Omrover/MoMa-robot/README.md

# MoMa-robot
Documentación del desarrollo del robot MoMa (requerimientos, arquitectura, BOM, diseños, códigos, control de stock).
