Omrover/MoMa-robot/docs/Documentación/Flujo de Ingeniería.pdf

### Diagrama de flujo propuesto

Inicio

Liberación de diseño de ingeniería Planos, BOM, diagramas eléctricos y especificaciones aprobadas

Validación de
documentación técnica

¿Documentación
completa y
aprobada?

Corrección /
actualización de
ingeniería

Verificación de
disponibilidad
de materiales

¿Todos los
materiales están
disponibles?

Solicitud a
Compras

Seguimiento
a proveedor

Recepción e
inspección

Generar Orden de Fabricación (OF)

Preparación de materiales / Kitting

Fabricación de piezas necesarias

Ensamble mecánico

Inspección mecánica
Torque, dimensiones, fijaciones y montaje

¿Ensamble
mecánico
conforme?

Retrabajo

Ensamble
eléctrico y
electrónico

Pruebas eléctricas
Continuidad, conexiones,
alimentación y seguridad

¿Sistema
eléctrico
conforme?

Corrección

Carga e
implementación
de
software/control

Integración de
subsistemas
Mecánica + electrónica +
software

Pruebas
funcionales
del sistema

¿Cumple
requerimientos
técnicos y de
seguridad?

Registrar no
conformidad

Análisis de
causa

Corrección/retrabajo

Control de
Calidad final
(QA)

Liberación
del equipo

Cierre de
Orden de
Fabricación

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
Añadir título

Archivos relevantes | Notas del chat

diagrama-flujo-agv.txt

### Diagrama de Flujo de Ingeniería

### Last Updated: 20 de ago. de 2026 Scope: Proceso completo de fabricación y liberación de un AMR, desde la liberación y validación del diseño de ingeniería hasta el cierre de la Orden de

Fabricación y la liberación final del equipo.

Referencias del
diagrama
Terminador
Proceso
Decisión

Proceso de Fabricación y Liberación de AGV

Información del diagrama
Este diagrama representa el flujo completo para fabricar, ensamblar, probar y liberar un vehículo guiado automático (AMR) inegrado con un brazo robótico. El proceso inicia con la liberación de la ingeniería, valida la documentación y los materiales, continúa con la fabricación e integración mecánica, eléctrica y de software, y finaliza con las pruebas, el control de calidad y el cierre de la orden de fabricación. Las rutas de corrección, retrabajo y abastecimiento aseguran que el equipo cumpla los requisitos técnicos y de seguridad.
