Omrover/MoMa-robot/docs/Documentación/Flujo_de_trabajo_Flexsim.jpeg

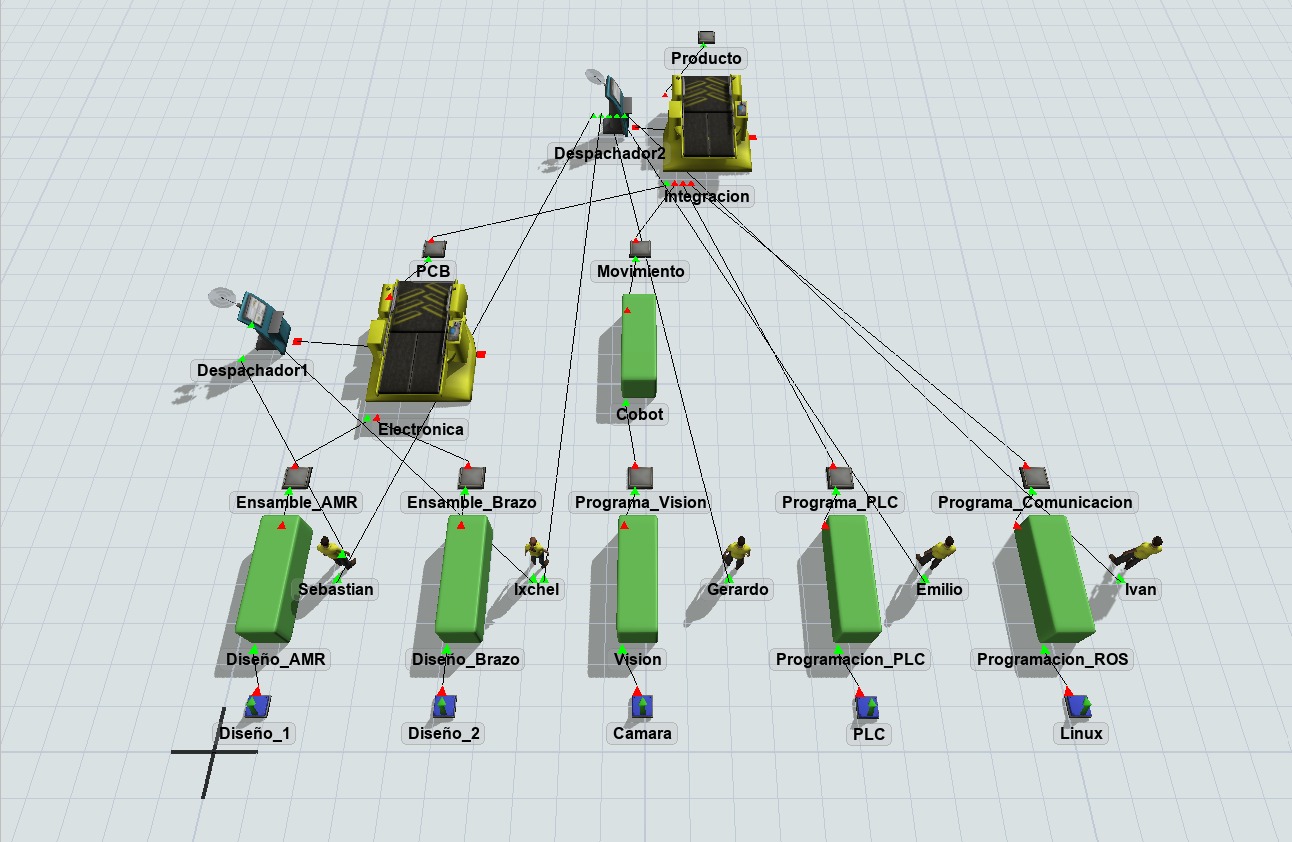
docs/Documentación/Flujo_de_trabajo_Flexsim.jpeg
