Omrover/MoMa-robot/docs/Documentación/Tablero_Kanban.png

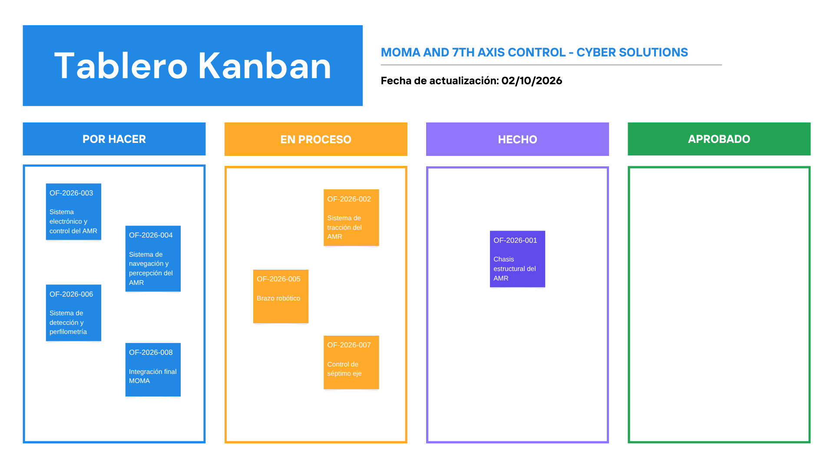
docs/Documentación/Tablero_Kanban.png
