Omrover/MoMa-robot/docs/Control Stock/OF_HojasViajeras_Materiales_ERP_CyberSolutions.xlsx

Sheet: Órdenes de fabricación
Órdenes de fabricación
ID | Fecha de emisión | Fecha liímite | Producto | Cantidad a producir | Prioridad
OF-2026-001 | 2026-09-03 | 2026-09-20 | Chasis estructural del AMR | 1 | ALTA
OF-2026-002 | 2026-09-04 | 2026-09-25 | Sistema de tracción del AMR | 1 | ALTA
OF-2026-003 | 2026-09-05 | 2026-09-27 | Sistema electrónico y control del AMR | 1 | ALTA
OF-2026-004 | 2026-09-06 | 2026-09-27 | Sistema de navegación y percepción del AMR | 1 | ALTA
OF-2026-005 | 2026-09-07 | 2026-09-28 | Brazo robótico | 1 | MEDIA
OF-2026-006 | 2026-09-08 | 2026-10-05 | Sistema de detección y perfilometría | 1 | BAJA
OF-2026-007 | 2026-09-09 | 2026-10-20 | Séptimo eje | 1 | BAJA
OF-2026-008 | 2026-09-10 | 2026-11-13 | Integración final MOMA | 1 | BAJA

Sheet: Hoja Viajera
 | HOJA VIAJERA DE PRODUCCIÓN
 | INFORMACIÓN DE LA ORDEN DE TRABAJO
 | N° Orden Trabajo: | OT-10025 |  |  |  | Fecha Inicio: | 2026-10-05
 | Producto/Parte: | AMR |  |  |  | Fecha Entrega: | 2026-12-04
 | Cantidad Requerida: | 1 |  |  |  | Cliente: | Socio Formador
ID | Op. | Centro de Trabajo | Descripción del Proceso | Operador | Inicio | Fin | Cant. Buena | Scrap | Firma Calidad
OF-2026-001 | 10 | Almacén | Surtido de material
 | 20 | Cortadora | Corte de PTR
 | 30 | Taladro | Perforaciones
 | 40 | Soldadura | Ensamble estructural
 | 50 | Rectificado | Acabado
 | 60 | Calidad | Inspección dimensional
OF-2026-002 | 10 | Almacén | Motores Chihai + drivers + batería + cable
 | 20 | Ensamble mecánico | Motores Chihai + ruedas
 | 30 | Ensamble mecánico | Ejes + elementos de transmisión
 | 40 | Ensamble eléctrico | Drivers Roboclaw
 | 50 | Cableado | Cable calibre 12
 | 60 | Pruebas eléctricas | Sistema de tracción
 | 70 | Pruebas funcionales | AMR
OF-2026-003 | 10 | Almacén | PCB + componentes electrónicos
 | 20 | Electrónica | PCB + resistencias
 | 30 | Electrónica | Optoacopladores + diodos + capacitores
 | 40 | Soldadura electrónica | PCB ensamblada
 | 50 | Programación | NXP / microcontrolador
 | 60 | Pruebas electrónicas | PCB
 | 70 | Integración eléctrica | PCB + sensores + cableado
 | 80 | Inspección | Sistema electrónico
OF-2026-004 | 10 | Almacén | Intel NUC + LiDAR + cámara
 | 20 | Ensamble | Soportes + Intel NUC
 | 30 | Ensamble | RPLiDAR
 | 40 | Ensamble | Logitech C920
 | 50 | Cableado | Cable UTP
 | 60 | Programación | NUC + software de navegación
 | 70 | Calibración | LiDAR + cámara
 | 80 | Pruebas | Sistema de navegación
OF-2026-005 | 10 | Almacén | Aluminio + acero + PLA-CF
 | 20 | Corte | Solera de aluminio
 | 30 | Maquinado | Componentes estructurales
 | 40 | Impresión 3D | PLA-CF
 | 50 | Ensamble mecánico | Estructura + piezas impresas
 | 60 | Ensamble | Rodamientos + tornillería
 | 70 | Ensamble eléctrico | Motores brushless
 | 80 | Ensamble eléctrico | Servomotor
 | 90 | Cableado | Cableado del brazo
 | 100 | Programación | Control del brazo
 | 110 | Pruebas | Movimiento de articulaciones
 | 120 | Inspección | Brazo robótico
OF-2026-006 | 10 | Almacén | Perfilómetro
 | 20 | Ensamble | Perfilómetro + soporte
 | 30 | Integración | Perfilómetro + computadora
 | 40 | Programación | Software de adquisición
 | 50 | Calibración | Perfilómetro
 | 60 | Procesamiento | Datos de perfil
 | 70 | Visión | Obtención de pose
 | 80 | Validación | Sistema de detección
OF-2026-007 | 10 | Almacén | Componentes del séptimo eje
 | 20 | Corte | Perfil/estructura
 | 30 | Maquinado | Soportes
 | 40 | Ensamble mecánico | Estructura + guía
 | 50 | Ensamble | Actuador + motor
 | 60 | Cableado | Motor + sensores
 | 70 | Programación | Control del eje
 | 80 | Calibración | Séptimo eje
 | 90 | Pruebas | Movimiento lineal
 | 100 | Inspección | Séptimo eje
OF-2026-008 | 10 | Almacén | AMR-001
 | 20 | Almacén | BRAZO-001
 | 30 | Ensamble | AMR + brazo
 | 40 | Integración | Sistema de perfilometría
 | 50 | Integración | Séptimo eje
 | 60 | Integración eléctrica | Cableado general
 | 70 | Integración de comunicaciones | AMR + visión + brazo + CNC
 | 80 | Calibración | Cámara
 | 90 | Calibración | Perfilómetro
 | 100 | Calibración | Brazo
 | 110 | Calibración | Séptimo eje
 | 120 | Integración CNC | MOMA + CNC
 | 130 | Pruebas | Detección de pieza
 | 140 | Pruebas | Cálculo de pose
 | 150 | Pruebas | Pick & place
 | 160 | Pruebas | Carga de pieza en CNC
 | 170 | Prueba final | Ciclo automático completo
 | 180 | Calidad | Inspección final

Sheet: consolidado_materiales
CONSOLIDADO MASTER DE MATERIALES Y COMPONENTES
ID | Proyecto | Componente / Descripción | Proveedor | Modelo / Código | Cantidad | Unidad | Subtotal Lineal ($) | Tiempo Entrega | País Origen | Contacto | Ficha Técnica | Fecha Cotización | Riesgo Suministro | Estatus OC
AMR | AMR | PTR 1/2''x1/2'' calibre 16 | MARSA ACEROS | Acero al carbón | 6 | metros | $600.00 | Inmediato | México | 3318941761 | https://neufert-cdn.archdaily.net/uploads/product_file/file/2979/Informaci_n_t_cnica_Tuber_a_y_Perfiles.pdf | 8/20/2026 | Bajo | Generado
AMR2 | AMR | Filamento para impresión | Amazon | Filamento Creality PLA-CF | 1 | kg | $472.00 | 2-5 días | México | https://www.amazon.com.mx/Creality-Filamento-Velocidad-Precisi%C3%B3n-Dimensional/dp/B0CW2HNX9Z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 | https://store.creality.com/es/products/hyper-pla-cf | 8/20/2026 | Medio | Generado
AMR3 | AMR | Motor | Aliexpress | Chihai | 4 | Pza | $2575.60 | 1-4 semanas | China | 86-14775544575 | https://es.aliexpress.com/item/32822227433.html?src=google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 | 8/20/2026 | Medio | Generado
AMR4 | AMR | Microcontrolador | NXP | NXP S32K344 | 1 | Pza | $1017.45 | 1 - 2 días | México | https://support.nxp.com/s/?language=en_US | S32K3xx Data Sheet | 8/20/2026 | Medio | Generado
AMR5 | AMR | PCB | JLCPCB | NA | 2 | Pza | $200.00 | 1 semana | China | hk@jlcpcb.com | ¿Qué es una PCB o Placa de Circuito Impreso? | Altium | 8/20/2026 | Medio | Generado
AMR6 | AMR | Computadora | Intel | Nuc 13 Pro | 1 | Pza | $8060.00 | 3 días | México | 33 2265 3660 | https://gzhls.at/blob/ldb/3/0/e/6/3258a588b77a736bbb371eaa7d358c35de33.pdf | 8/20/2026 | Bajo | Generado
AMR7 | AMR | Lidar | ZICZNT | Rplidar A1M8 | 1 | Pza | $1525.83 | 2 semanas | China | support@siminics.com | https://www.slamtec.com/en/lidar/a1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 | 8/20/2026 | Medio | Generado
AMR8 | AMR | Web cam | Amazon | Logitech C920 | 1 | Pza | $1222.00 | 2-5 días | México | https://www.amazon.com.mx/Logitech-Webcam-Resoluci%C3%B3n-FullHD-1080p/dp/B006JH8T3S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 | https://www.logitech.com/es-mx/shop/p/c920-pro-hd-webcam | 8/20/2026 | Bajo | Generado
AMR9 | AMR | Drivers | SanDoRobotics | Roboclaw 2x45 | 2 | Pza | $12960.00 | 3-7 días | México | 5557683208 | https://core-electronics.com.au/attachments/localcontent/roboclaw_datasheet_ST_2x45A_43321507500.pdf | 8/20/2026 | Bajo | Generado
AMR10 | AMR | Resistencia | Mexbit | 10 k omh | 10 | Pza | $20.00 | inmediato | México | 33 34495988 | RESISTOR Datasheet(PDF) - DMR16 - Dubilier | 8/20/2026 | Bajo | Generado
AMR11 | AMR | Optoacoplador | Mexbit | 4n25 | 10 | Pza | $80.00 | inmediato | México | 33 34495988 | 4n25.pdf | 8/20/2026 | Bajo | Generado
AMR12 | AMR | Diodo | Mexbit | 1n4007 | 10 | Pza | $30.00 | inmediato | México | 33 34495988 | 1N4007 Datasheet(PDF) - Diodes Incorporated | 8/20/2026 | Bajo | Generado
AMR13 | AMR | Capacitor | Mexbit | 10 mF | 10 | Pza | $40.00 | inmediato | México | 33 34495988 | 10 mF Aluminum Electrolytic Capacitors | Capacitors | DigiKey | 8/20/2026 | Bajo | Generado
AMR14 | AMR | Cables UTP | Mexbit | UTP | 5 | m | $30.00 | inmediato | México | 33 34495988 | https://assets.tripplite.com/product-pdfs/es/n002006bl.pdf | 8/20/2026 | Bajo | Generado
AMR142 | AMR | Cable Calibre 12 | Mexbit | Calibre 12 | 3 | m | $30.00 | Inmediato | México | 33 34495988 | Ficha Técnica | 8/20/2026 | Bajo | Generado
AMR15 | AMR | Bateria | Aliexpress | 24V LiPo | 1 | Pza | $1400.00 | 2-4 semanas | China | 1103456202 | 24V 30Ah 6s3p 18650 batería de litio 24V 30000mAh batería de iones de litio + cargador - AliExpress 44 | 8/20/2026 | Medio | Generado
AMR16 | AMR | Sensor Infrarrojo difuso | Amazon | E18-B03N1 | 5 | Pza | $825.00 | 2 semanas | China | https://www.amazon.com.mx/Sensor-fotoel%C3%A9ctrico-interruptor-E18-B03P1-Interruptor/dp/B07SW6JF6S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 | E18-B03N1 Infrared Proximity Photoelectric Switch | RAM Electronics | 8/20/2026 | Medio | Generado
Brazo robotico | Brazo Robótico | Motor brushless 8NM GIM8108-48 | Elf te Motor-Steadywin Official Store | GIM8108-8 | 3 | Pza | $1706.70 | 1 - 4 semanas | China | +86 13077918423 | https://ae-pic-a1.aliexpress-media.com/kf/Sb67d8ccea6ae4649b51a2712f7c8611eg.pdf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 | 8/20/2026 | Medio | Generado
Brazo robotico 2 | Brazo Robótico | Motor brushless 3NM | Elf te Motor-Steadywin Official Store | GB3506 | 3 | Pza | $1450.20 | 2 - 4 semanas | China | +86 13077918423 | https://steadywin-motor.com/cdn/shop/files/3506_2000x.jpg?v=1750326533 | 8/20/2026 | Medio | Generado
Brazo robotico 3 | Brazo Robótico | Filamento para impresión | Amazon | Filamento Creality PLA-CF | 3 | kg | $1260.00 | 2-5 días | México | https://www.amazon.com.mx/Creality-Filamento-Velocidad-Precisi%C3%B3n-Dimensional/dp/B0CW2HNX9Z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 | https://store.creality.com/es/products/hyper-pla-cf | 8/20/2026 | Medio | Generado
Brazo robotico 4 | Brazo Robótico | Servomotor | Steren | MOT-135 | 1 | Pza | $199.00 | inmediato | México | 55 1516 6000 | https://www.steren.com.mx/servomotor-con-torque-de-10-kgf-cm.html | 8/20/2026 | Bajo | Generado
Brazo robotico 5 | Brazo Robótico | Cables UTP | Mexbit | UTP | 5 | m | $30.00 | inmediato | México | 33 34495988 | https://assets.tripplite.com/product-pdfs/es/n002006bl.pdf | 8/20/2026 | Bajo | Generado
Brazo robotico 6 | Brazo Robótico | Cable Calibre 12 | Mexbit | Calibre 12 | 3 | m | $30.00 | Inmediato | México | 34 34495988 | Ficha Técnica | 8/20/2026 | Bajo | Generado
Brazo robotico 7 | Brazo Robótico | Lamina de acero | MARSA ACEROS | Calibre 16 | 1 | kg | $28.00 | Inmediato | México | 3318941761 | https://acerosmarsal.com.mx/lamina-rc/ | 8/20/2026 | Bajo | Generado
Brazo robotico 8 | Brazo Robótico | Solera de alumino | Mar China | Aluminio 6061 | 4 | ''x14''x1/4'' | $2720.88 | Inmediato | México | 33 3620 8756 | SOLERA 1/4 x 6 plg ALUMINIO 17592 | METALES MarChina - ¡Todo en Aluminio, Metales NO Ferrosos y Plásticos! | 8/20/2026 | Bajo | Generado
Brazo robotico 9 | Brazo Robótico | tornillos | Lizar | Allen | 40 | Pza | $200.00 | Inmediato | México | 33 3124 5228 | https://es.scribd.com/document/1065520561/Ficha-Tecnica-Torn-Allen-Cilindrico-Metrico | 8/20/2026 | Bajo | Generado
Brazo robotico 10 | Brazo Robótico | Rodamiento de rodillos cruzados | Amazon | SHF-14 | 1 | Pza | $2566.00 | 3-10 días | Estados Unidos | https://www.amazon.com.mx/Rodamiento-rodillos-cruzados-SHF-14-SHF-17/dp/B0HCNCN74D | https://lkpbearing.com/shf14-shg14-harmonic-reducer-bearings/ | 8/20/2026 | Medio | Generado
 |  | TOTAL CONSOLIDADO |  |  |  |  | $41278.66

Sheet: Maestro Materiales ERP
MÓDULO ERP: CONTROL Y GENERACIÓN DE CÓDIGOS DE MATERIALES
CÓDIGO ERP (Autogenerado) | Categoría | Tipo de Material | Número de Parte | Descripción Completa | Fabricante / Marca | UOM (Unidad) | Costo Unitario | Stock Actual
MEC-MOT-CHI-000 | MECÁNICA | Motor | CHI-000 | Chihai motor Gear Motor CHP-42GP-775-ABHL 24V 165rmp-i49 | Chihai | PZA | $786.00 | 4
MEC-MOT-BRUSH-000 | MECÁNICA | Motor | BRUSH-000 | Motor brushless 8NM GIM8108-48 |  | PZA | $586.00 | 3
COM-MICRO-NXP-312 | COMPUTACIÓN | Microcontrolador | NXP-312 | Microcontrolador NXP S32K312MINI-EVB | NXP | PZA | $600.00 | 5
MEC-FIL-PLA-000 | MECÁNICA | Filamento para impresión 3D | PLA-000 | Filamento PLA Standard Hatchbox | Hatchbox | PZA | $472.00 | 1
MEC-FIL-TPU-000 | MECÁNICA | Filamento para impresión 3D | TPU-000 | Filamento TPU CR Series Creality | Creality | PZA | $500.00 | 1
INT-DVR-RC-000 | INSTRUMENTACION | Driver | RC-000 | Driver de motor Roboclaw 2x45ST | Roboclaw | PZA | $6480.00 | 2
MEC-ROD-SH14-000 | MECÁNICA | Rodamiento | SHF14-000 | Rodamiento de rodillos cruzados SHF-14 | EFANT | PZA | $689.90 | 1
ELE-BAT-SOCO-000 | ELECTRÓNICA | Bateria | SOCO-000 | Batería de 24V 6000mAh | SOCOKIN | PZA | $4027.00 | 1
ELE-BAT-TEST-000 | ELECTRÓNICA | LiPo Tester | TEST-000 | Probador de voltaje de batería LiPo | Vbestlife | PZA | $65.00 | 1
ELE-ENC-ENCO-000 | ELECTRÓNICA | Encoder | ENCO-000 | Encoder de doble cuadratura | OMRON | PZA | $1750.00 | 4
ELE-LiD-LiD-000 | ELECTRÓNICA | LiDAR | LiD-000 | LiDAR | RPLiDAR | PZA | $1500.00 | 1
MEC-TER-HEAT-000 | MECÁNICA | Tubo termorretráctil | HEAT-000 | Tubo termorretráctil 45mm - 1m | Shenzhen Tianshen Technology | PZA | $94.10 | 4
MEC-POL-POL-518 | MECÁNICA | Poleas | POL-518 | Poleas HDT5M 18 dientes | RUIYONG HARDWARE | PZA | $169.64 | 4
MEC-ROD-BAL-604 | MECÁNICA | Rodamiento | BAL-604 | Rodamiento radial rígido de bolas 604 (12mm*4mm*4mm) | Genérico | PZA | $3.44 | 120
MEC-TOR-TOR-460 | MECÁNICA | Tornillo allen | TOR-460 | Tornillo allen cilíndrico inoxidable M4*60 | JING DOU Hardware | PZA | $4.36 | 20
MEC-TOR-TOR-480 | MECÁNICA | Tornillo allen | TOR-480 | Tornillo allen cilíndrico inoxidable M4*80 | JING DOU Hardware | PZA | $4.36 | 50
MEC-BAN-BAN-475 | MECÁNICA | Banda de transmisión | BAN-475 | Banda HTD 475-5M | FULO | PZA | $1105.80 | 3
MEC-BAN-BAN-410 | MECÁNICA | Banda de transmisión | BAN-410 | Banda HTD 410-5M | Uxcell | PZA | $620.63 | 2
MEC-BAN-BAN-405 | MECÁNICA | Banda de transmisión | BAN-405 | Banda HTD 405-5M | FULO | PZA | $399.00 | 2
MEC-BAN-BAN-102 | MECÁNICA | Banda de transmisión | BAN-102 | Banda 102 XL | P&W | PZA | $498.00 | 3
MEC-EJE-EJE-105 | MECÁNICA | Eje | EJE-105 | Eje acero inoxidable 10mm de diametro 50cm largo | Yunshuo | PZA | $252.55 | 1
COM-MICRO-NXP-344 | COMPUTACIÓN | Microcontrolador | NXP-344 | Microcontrolador NXP FRDM-A-S32K344 | NXP | PZA | $1129.00 | 2
ELE-CON-CON-485 | ELECTRÓNICA | Convertidor | CON-485 | Convertidor USB a RS485 | Walfront | PZA | $199.00 | 1
MEC-FIL-FFC-000 | MECÁNICA | Filamento para impresión 3D | FFC-000 | Filamento Fibra de Carbono 1.75mm 1KG Púrpura | Creality | PZA | $589.49 | 1
MEC-ROD-BAL-690 | MECÁNICA | Rodamiento | BAL-690 | Rodamiento radial rígido de bolas 6900-2RS (22mm*10mm*6mm) | GMG | PZA | $14.90 | 10
