Omrover/MoMa-robot/docs/Control Stock/Ordenes_de_Compra_CyberSolutions.xlsx

Sheet: Resumen_General
CYBERSOLUTIONS S.A. DE C.V.
DASHBOARD DE ÓRDENES DE COMPRA Y MATERIALES DE PROYECTO
Total Proveedores |  | Total Componentes |  | Monto Total Consolidado
13 |  | 27 |  | $41705.78
RESUMEN DE ÓRDENES DE COMPRA POR PROVEEDOR
N° | Proveedor | Orden de Compra | Ítems | Subtotal (MXN) | IVA 16% (MXN) | Total (MXN)
1 | MARSA ACEROS | OC-2026-001 | 2 | $628.00 | $100.48 | $728.48
2 | Amazon | OC-2026-002 | 5 | $6345.00 | $1015.20 | $7360.20
3 | Aliexpress | OC-2026-003 | 5 | $15167.60 | $2426.82 | $17594.42
4 | NXP | OC-2026-004 | 1 | $1017.45 | $162.79 | $1180.24
5 | JLCPCB | OC-2026-005 | 1 | $200.00 | $32.00 | $232.00
6 | Intel | OC-2026-006 | 1 | $8060.00 | $1289.60 | $9349.60
7 | ZICZNT | OC-2026-007 | 1 | $1525.83 | $244.13 | $1769.96
8 | SanDoRobotics | OC-2026-008 | 1 | $12960.00 | $2073.60 | $15033.60
9 | Mexbit | OC-2026-009 | 8 | $290.00 | $46.40 | $336.40
10 | Elf te Motor-Steadywin Official Store | OC-2026-010 | 2 | $3156.90 | $505.10 | $3662.00
11 | Steren | OC-2026-011 | 1 | $199.00 | $31.84 | $230.84
12 | Mar China | OC-2026-012 | 1 | $2720.88 | $435.34 | $3156.22
13 | Lizar | OC-2026-013 | 1 | $200.00 | $32.00 | $232.00
 | TOTAL GENERAL |  | 30 | $52470.66 | $8395.31 | $60865.97

Sheet: Consolidado_Materiales
CONSOLIDADO MASTER DE MATERIALES Y COMPONENTES
ID | Proyecto | Componente / Descripción | Proveedor | Modelo / Código | Cantidad | Unidad | Subtotal Lineal ($) | Tiempo Entrega | País Origen | Contacto | Ficha Técnica | Fecha Cotización | Riesgo Suministro | Estatus OC
AMR | AMR | PTR 1/2''x1/2'' calibre 16 | MARSA ACEROS | Acero al carbón | 6 | metros | $600.00 | Inmediato | México | 3318941761 | https://neufert-cdn.archdaily.net/uploads/product_file/file/2979/Informaci_n_t_cnica_Tuber_a_y_Perfiles.pdf | 8/20/2026 | Bajo | Generado
AMR2 | AMR | Filamento para impresión | Amazon | Filamento Creality PLA-CF | 1 | kg | $472.00 | 2-5 días | México | https://www.amazon.com.mx/Creality-Filamento-Velocidad-Precisi%C3%B3n-Dimensional/dp/B0CW2HNX9Z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 | https://store.creality.com/es/products/hyper-pla-cf | 8/20/2026 | Medio | Generado
AMR3 | AMR | Motor | Aliexpress | Chihai | 4 | Pza | $2575.60 | 1-4 semanas | China | 86-14775544575 | https://es.aliexpress.com/item/32822227433.html?src=google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 | 8/20/2026 | Medio | Generado
AMR4 | AMR | Microcontrolador | NXP | NXP S32K344 | 1 | Pza | $1017.45 | 1 - 2 días | México | https://support.nxp.com/s/?language=en_US | S32K3xx Data Sheet | 8/20/2026 | Medio | Generado
AMR5 | AMR | PCB | JLCPCB | NA | 2 | Pza | $200.00 | 1 semana | China | hk@jlcpcb.com | ¿Qué es una PCB o Placa de Circuito Impreso? | Altium | 8/20/2026 | Medio | Generado
AMR6 | AMR | Computadora | Intel | Nuc 13 Pro | 1 | Pza | $8060.00 | 3 días | México | 33 2265 3660 | https://gzhls.at/blob/ldb/3/0/e/6/3258a588b77a736bbb371eaa7d358c35de33.pdf | 8/20/2026 | Bajo | Generado
AMR7 | AMR | Lidar | ZICZNT | Rplidar A1M8 | 1 | Pza | $1525.83 | 2 semanas | China | support@siminics.com | https://www.slamtec.com/en/lidar/a1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 | 8/20/2026 | Medio | Generado
AMR8 | AMR | Web cam | Amazon | Logitech C920 | 1 | Pza | $1222.00 | 2-5 días | México | https://www.amazon.com.mx/Logitech-Webcam-Resoluci%C3%B3n-FullHD-1080p/dp/B006JH8T3S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 | https://www.logitech.com/es-mx/shop/p/c920-pro-hd-webcam | 8/20/2026 | Bajo | Generado
AMR9 | AMR | Drivers | SanDoRobotics | Roboclaw 2x45 | 2 | Pza | $12960.00 | 3-7 días | México | 5557683208 | https://core-electronics.com.au/attachments/localcontent/roboclaw_datasheet_ST_2x45A_43321507500.pdf | 8/20/2026 | Bajo | Generado
AMR10 | AMR | Resistencia | Mexbit | 10 k omh | 10 | Pza | $20.00 | inmediato | México | 33 34495988 | RESISTOR Datasheet(PDF) - DMR16 - Dubilier | 8/20/2026 | Bajo | Generado
AMR11 | AMR | Optoacoplador | Mexbit | 4n25 | 10 | Pza | $80.00 | inmediato | México | 33 34495988 | 4n25.pdf | 8/20/2026 | Bajo | Generado
AMR12 | AMR | Diodo | Mexbit | 1n4007 | 10 | Pza | $30.00 | inmediato | México | 33 34495988 | 1N4007 Datasheet(PDF) - Diodes Incorporated | 8/20/2026 | Bajo | Generado
AMR13 | AMR | Capacitor | Mexbit | 10 mF | 10 | Pza | $40.00 | inmediato | México | 33 34495988 | 10 mF Aluminum Electrolytic Capacitors | Capacitors | DigiKey | 8/20/2026 | Bajo | Generado
AMR14 | AMR | Cables UTP | Mexbit | UTP | 5 | m | $30.00 | inmediato | México | 33 34495988 | https://assets.tripplite.com/product-pdfs/es/n002006bl.pdf | 8/20/2026 | Bajo | Generado
AMR15 | AMR | Cable Calibre 12 | Mexbit | Calibre 12 | 3 | m | $30.00 | Inmediato | México | 33 34495988 | Ficha Técnica | 8/20/2026 | Bajo | Generado
AMR16 | AMR | Bateria | Aliexpress | 24V LiPo | 1 | Pza | $4027.00 | 2-4 semanas | China | 1103456202 | 24V 30Ah 6s3p 18650 batería de litio 24V 30000mAh batería de iones de litio + cargador - AliExpress 44 | 8/20/2026 | Medio | Generado
AMR17 | AMR | Sensor Infrarrojo difuso | Amazon | E18-B03N1 | 5 | Pza | $825.00 | 2 semanas | China | https://www.amazon.com.mx/Sensor-fotoel%C3%A9ctrico-interruptor-E18-B03P1-Interruptor/dp/B07SW6JF6S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 | E18-B03N1 Infrared Proximity Photoelectric Switch | RAM Electronics | 8/20/2026 | Medio | Generado
AMR18 | AMR | Probador de baterías LiPo | Aliexpress | Bx100 1-8s | 1 | Pza | $65.00 | 1 - 4 semanas | China | +86 13077918423 | https://ae-pic-a1.aliexpress-media.com/kf/Sb67d8ccea6ae4649b51a2712f7c8611eg.pdf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 | 8/20/2026 | Medio | Generado
AMR19 | AMR | Encoder doble cuadratura | Aliexpress | omron e6b2-cwz5b | 4 | Pza | $1750.00 | 2 - 4 semanas | China | +86 13077918423 | https://steadywin-motor.com/cdn/shop/files/3506_2000x.jpg?v=1750326533 | 8/20/2026 | Medio | Generado
AMR20 | AMR | Sensor LiDAR | Aliexpress | A1m8 2d | 1 | Pza | $1500.00 | 2-5 días | China | https://www.amazon.com.mx/Creality-Filamento-Velocidad-Precisi%C3%B3n-Dimensional/dp/B0CW2HNX9Z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 | https://store.creality.com/es/products/hyper-pla-cf | 8/20/2026 | Medio | Generado
Brazo robotico | Brazo Robótico | Motor brushless 8NM GIM8108-48 | Elf te Motor-Steadywin Official Store | GIM8108-8 | 3 | Pza | $1706.70 | 1 - 4 semanas | China | +86 13077918423 | https://ae-pic-a1.aliexpress-media.com/kf/Sb67d8ccea6ae4649b51a2712f7c8611eg.pdf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 | 8/20/2026 | Medio | Generado
Brazo robotico 2 | Brazo Robótico | Motor brushless 3NM | Elf te Motor-Steadywin Official Store | GB3506 | 3 | Pza | $1450.20 | 2 - 4 semanas | China | +86 13077918423 | https://steadywin-motor.com/cdn/shop/files/3506_2000x.jpg?v=1750326533 | 8/20/2026 | Medio | Generado
Brazo robotico 3 | Brazo Robótico | Filamento para impresión | Amazon | Filamento Creality PLA-CF | 3 | kg | $1260.00 | 2-5 días | México | https://www.amazon.com.mx/Creality-Filamento-Velocidad-Precisi%C3%B3n-Dimensional/dp/B0CW2HNX9Z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 | https://store.creality.com/es/products/hyper-pla-cf | 8/20/2026 | Medio | Generado
Brazo robotico 4 | Brazo Robótico | Servomotor | Steren | MOT-135 | 1 | Pza | $199.00 | inmediato | México | 55 1516 6000 | https://www.steren.com.mx/servomotor-con-torque-de-10-kgf-cm.html | 8/20/2026 | Bajo | Generado
Brazo robotico 5 | Brazo Robótico | Cables UTP | Mexbit | UTP | 5 | m | $30.00 | inmediato | México | 33 34495988 | https://assets.tripplite.com/product-pdfs/es/n002006bl.pdf | 8/20/2026 | Bajo | Generado
Brazo robotico 6 | Brazo Robótico | Cable Calibre 12 | Mexbit | Calibre 12 | 3 | m | $30.00 | Inmediato | México | 34 34495988 | Ficha Técnica | 8/20/2026 | Bajo | Generado
Brazo robotico 7 | Brazo Robótico | Lamina de acero | MARSA ACEROS | Calibre 16 | 1 | kg | $28.00 | Inmediato | México | 3318941761 | https://acerosmarsal.com.mx/lamina-rc/ | 8/20/2026 | Bajo | Generado
Brazo robotico 8 | Brazo Robótico | Solera de alumino | Mar China | Aluminio 6061 | 4 | ''x14''x1/4'' | $2720.88 | Inmediato | México | 33 3620 8756 | SOLERA 1/4 x 6 plg ALUMINIO 17592 | METALES MarChina - ¡Todo en Aluminio, Metales NO Ferrosos y Plásticos! | 8/20/2026 | Bajo | Generado
Brazo robotico 9 | Brazo Robótico | tornillos | Lizar | Allen | 40 | Pza | $200.00 | Inmediato | México | 33 3124 5228 | https://es.scribd.com/document/1065520561/Ficha-Tecnica-Torn-Allen-Cilindrico-Metrico | 8/20/2026 | Bajo | Generado
Brazo robotico 10 | Brazo Robótico | Rodamiento de rodillos cruzados | Amazon | SHF-14 | 1 | Pza | $2566.00 | 3-10 días | Estados Unidos | https://www.amazon.com.mx/Rodamiento-rodillos-cruzados-SHF-14-SHF-17/dp/B0HCNCN74D | https://lkpbearing.com/shf14-shg14-harmonic-reducer-bearings/ | 8/20/2026 | Medio | Generado
 |  | TOTAL CONSOLIDADO |  |  |  |  | $43573.06

Sheet: MARSA ACEROS
ORDEN DE COMPRA
CyberSolutions S.A. de C.V. |  |  |  |  | N° de Orden: | OC-2026-001
Avenida Aviación 4304, Zapopan, Jalisco | Av. General Ramon Corona |  |  |  | Fecha: | 20/08/2026
Correo: compras@cybersolutions.com | Tel: 341 646 1280 |  |  |  |  | Términos: | 30 días netos
DATOS DEL PROVEEDOR |  |  |  | ENVIAR A |  |  |  | Simbología
Empresa: | MARSA ACEROS |  |  | Empresa: | CyberSolutions S.A. de C.V. |  |  | Status entregado
Atención: | Atención a Clientes |  |  | Atención: | Depto. de Almacén y Logística |  |  | Status en camino
Dirección: | País: México |  |  | Dirección: | Avenida Aviación 4304, Zapopan |  |  | Status por salir
Tel/Email: | 3318941761 |  |  | Notas: | Tel: 341 646 1280
Ítem | Código | Descripción | Cantidad | Unidad | Precio Unitario | Importe | Status
1 | Acero al carbón | PTR 1/2''x1/2'' calibre 16 | 6 | metros | $100.00 | $600.00
2 | Calibre 16 | Lamina de acero | 1 | kg | $28.00 | $28.00
 |  |  |  |  | Subtotal: | $628.00
 |  |  |  |  | IVA (16%): | $100.48
Autorizado por: | _________________________ |  |  |  | TOTAL: | $728.48

Sheet: Amazon
ORDEN DE COMPRA
CyberSolutions S.A. de C.V. |  |  |  |  | N° de Orden: | OC-2026-002
Avenida Aviación 4304, Zapopan, Jalisco | Av. General Ramon Corona |  |  |  | Fecha: | 20/08/2026
Correo: compras@cybersolutions.com | Tel: 341 646 1280 |  |  |  |  | Términos: | 30 días netos
DATOS DEL PROVEEDOR |  |  |  | ENVIAR A |  |  |  | Simbología
Empresa: | Amazon |  |  | Empresa: | CyberSolutions S.A. de C.V. |  |  | Status entregado
Atención: | Atención a Clientes |  |  | Atención: | Depto. de Almacén y Logística |  |  | Status en camino
Dirección: | País: México |  |  | Dirección: | Avenida Aviación 4304, Zapopan |  |  | Status por salir
Tel/Email: | https://www.amazon.com.mx/Creality-Filamento-Velocidad-Precisi%C3%B3n-Dimensional/dp/B0CW2HNX9Z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 |  |  | Notas: | Tel: 341 646 1280
Ítem | Código | Descripción | Cantidad | Unidad | Precio Unitario | Importe | Status
1 | Filamento Creality PLA-CF | Filamento para impresión | 1 | kg | $472.00 | $472.00
2 | Logitech C920 | Web cam | 1 | Pza | $1222.00 | $1222.00
3 | E18-B03N1 | Sensor Infrarrojo difuso | 5 | Pza | $165.00 | $825.00
4 | Filamento Creality PLA-CF | Filamento para impresión | 3 | kg | $420.00 | $1260.00
5 | SHF-14 | Rodamiento de rodillos cruzados | 1 | Pza | $2566.00 | $2566.00
 |  |  |  |  | Subtotal: | $6345.00
 |  |  |  |  | IVA (16%): | $1015.20
Autorizado por: | _________________________ |  |  |  | TOTAL: | $7360.20

Sheet: Aliexpress
ORDEN DE COMPRA
CyberSolutions S.A. de C.V. |  |  |  |  | N° de Orden: | OC-2026-003
Avenida Aviación 4304, Zapopan, Jalisco | Av. General Ramon Corona |  |  |  | Fecha: | 20/08/2026
Correo: compras@cybersolutions.com | Tel: 341 646 1280 |  |  |  |  | Términos: | 30 días netos
DATOS DEL PROVEEDOR |  |  |  | ENVIAR A |  |  |  | Simbología
Empresa: | Aliexpress |  |  | Empresa: | CyberSolutions S.A. de C.V. |  |  | Status entregado
Atención: | Atención a Clientes |  |  | Atención: | Depto. de Almacén y Logística |  |  | Status en camino
Dirección: | País: China |  |  | Dirección: | Avenida Aviación 4304, Zapopan |  |  | Status por salir
Tel/Email: | 86-14775544575 |  |  | Notas: | Tel: 341 646 1280
Ítem | Código | Descripción | Cantidad | Unidad | Precio Unitario | Importe | Status
1 | Chihai | Motor | 4 | Pza | $643.90 | $2575.60
2 | 24V LiPo | Bateria | 1 | Pza | $4027.00 | $4027.00
3 | Lipo Tester | Probador de Batería | 1 | Pza | $65.00 | $65.00
4 | Encoder | Encoder de doble cuadratura | 4 | Pza | $1750.00 | $7000.00
5 | LiDAR | Sensor de deteción de luz y rango | 1 | Pza | $1500.00 | $1500.00
 |  |  |  |  | Subtotal: | $15167.60
 |  |  |  |  | IVA (16%): | $2426.82
Autorizado por: | _________________________ |  |  |  | TOTAL: | $17594.42

Sheet: NXP
ORDEN DE COMPRA
CyberSolutions S.A. de C.V. |  |  |  |  | N° de Orden: | OC-2026-004
Avenida Aviación 4304, Zapopan, Jalisco | Av. General Ramon Corona |  |  |  | Fecha: | 20/08/2026
Correo: compras@cybersolutions.com | Tel: 341 646 1280 |  |  |  |  | Términos: | 30 días netos
DATOS DEL PROVEEDOR |  |  |  | ENVIAR A |  |  |  | Simbología
Empresa: | NXP |  |  | Empresa: | CyberSolutions S.A. de C.V. |  |  | Status entregado
Atención: | Atención a Clientes |  |  | Atención: | Depto. de Almacén y Logística |  |  | Status en camino
Dirección: | País: México |  |  | Dirección: | Avenida Aviación 4304, Zapopan |  |  | Status por salir
Tel/Email: | https://support.nxp.com/s/?language=en_US |  |  | Notas: | Tel: 341 646 1280
Ítem | Código | Descripción | Cantidad | Unidad | Precio Unitario | Importe | Status
1 | NXP S32K344 | Microcontrolador | 1 | Pza | $1017.45 | $1017.45
 |  |  |  |  | Subtotal: | $1017.45
 |  |  |  |  | IVA (16%): | $162.79
Autorizado por: | _________________________ |  |  |  | TOTAL: | $1180.24

Sheet: JLCPCB
ORDEN DE COMPRA
CyberSolutions S.A. de C.V. |  |  |  |  | N° de Orden: | OC-2026-005
Avenida Aviación 4304, Zapopan, Jalisco | Av. General Ramon Corona |  |  |  | Fecha: | 20/08/2026
Correo: compras@cybersolutions.com | Tel: 341 646 1280 |  |  |  |  | Términos: | 30 días netos
DATOS DEL PROVEEDOR |  |  |  | ENVIAR A |  |  |  | Simbología
Empresa: | JLCPCB |  |  | Empresa: | CyberSolutions S.A. de C.V. |  |  | Status entregado
Atención: | Atención a Clientes |  |  | Atención: | Depto. de Almacén y Logística |  |  | Status en camino
Dirección: | País: China |  |  | Dirección: | Avenida Aviación 4304, Zapopan |  |  | Status por salir
Tel/Email: | hk@jlcpcb.com |  |  | Notas: | Tel: 341 646 1280
Ítem | Código | Descripción | Cantidad | Unidad | Precio Unitario | Importe | Status
1 | PCB | Placa de circuito impreso | 2 | Pza | $100.00 | $200.00
 |  |  |  |  | Subtotal: | $200.00
 |  |  |  |  | IVA (16%): | $32.00
Autorizado por: | _________________________ |  |  |  | TOTAL: | $232.00

Sheet: Intel
ORDEN DE COMPRA
CyberSolutions S.A. de C.V. |  |  |  |  | N° de Orden: | OC-2026-006
Avenida Aviación 4304, Zapopan, Jalisco | Av. General Ramon Corona |  |  |  | Fecha: | 20/08/2026
Correo: compras@cybersolutions.com | Tel: 341 646 1280 |  |  |  |  | Términos: | 30 días netos
DATOS DEL PROVEEDOR |  |  |  | ENVIAR A
Empresa: | Intel |  |  | Empresa: | CyberSolutions S.A. de C.V.
Atención: | Atención a Clientes |  |  | Atención: | Depto. de Almacén y Logística
Dirección: | País: México |  |  | Dirección: | Avenida Aviación 4304, Zapopan
Tel/Email: | 33 2265 3660 |  |  | Notas: | Tel: 341 646 1280
Ítem | Código | Descripción | Cantidad | Unidad | Precio Unitario | Importe
1 | Nuc 13 Pro | Computadora | 1 | Pza | $8060.00 | $8060.00
 |  |  |  |  | Subtotal: | $8060.00
 |  |  |  |  | IVA (16%): | $1289.60
Autorizado por: | _________________________ |  |  |  | TOTAL: | $9349.60

Sheet: ZICZNT
ORDEN DE COMPRA
CyberSolutions S.A. de C.V. |  |  |  |  | N° de Orden: | OC-2026-007
Avenida Aviación 4304, Zapopan, Jalisco | Av. General Ramon Corona |  |  |  | Fecha: | 20/08/2026
Correo: compras@cybersolutions.com | Tel: 341 646 1280 |  |  |  |  | Términos: | 30 días netos
DATOS DEL PROVEEDOR |  |  |  | ENVIAR A
Empresa: | ZICZNT |  |  | Empresa: | CyberSolutions S.A. de C.V.
Atención: | Atención a Clientes |  |  | Atención: | Depto. de Almacén y Logística
Dirección: | País: China |  |  | Dirección: | Avenida Aviación 4304, Zapopan
Tel/Email: | support@siminics.com |  |  | Notas: | Tel: 341 646 1280
Ítem | Código | Descripción | Cantidad | Unidad | Precio Unitario | Importe
1 | Rplidar A1M8 | Lidar | 1 | Pza | $1525.83 | $1525.83
 |  |  |  |  | Subtotal: | $1525.83
 |  |  |  |  | IVA (16%): | $244.13
Autorizado por: | _________________________ |  |  |  | TOTAL: | $1769.96

Sheet: SanDoRobotics
ORDEN DE COMPRA
CyberSolutions S.A. de C.V. |  |  |  |  | N° de Orden: | OC-2026-008
Avenida Aviación 4304, Zapopan, Jalisco | Av. General Ramon Corona |  |  |  | Fecha: | 20/08/2026
Correo: compras@cybersolutions.com | Tel: 341 646 1280 |  |  |  |  | Términos: | 30 días netos
DATOS DEL PROVEEDOR |  |  |  | ENVIAR A
Empresa: | SanDoRobotics |  |  | Empresa: | CyberSolutions S.A. de C.V.
Atención: | Atención a Clientes |  |  | Atención: | Depto. de Almacén y Logística
Dirección: | País: México |  |  | Dirección: | Avenida Aviación 4304, Zapopan
Tel/Email: | 5557683208 |  |  | Notas: | Tel: 341 646 1280
Ítem | Código | Descripción | Cantidad | Unidad | Precio Unitario | Importe
1 | Roboclaw 2x45 | Drivers | 2 | Pza | $6480.00 | $12960.00
 |  |  |  |  | Subtotal: | $12960.00
 |  |  |  |  | IVA (16%): | $2073.60
Autorizado por: | _________________________ |  |  |  | TOTAL: | $15033.60

Sheet: Mexbit
ORDEN DE COMPRA
CyberSolutions S.A. de C.V. |  |  |  |  | N° de Orden: | OC-2026-009
Avenida Aviación 4304, Zapopan, Jalisco | Av. General Ramon Corona |  |  |  | Fecha: | 20/08/2026
Correo: compras@cybersolutions.com | Tel: 341 646 1280 |  |  |  |  | Términos: | 30 días netos
DATOS DEL PROVEEDOR |  |  |  | ENVIAR A
Empresa: | Mexbit |  |  | Empresa: | CyberSolutions S.A. de C.V.
Atención: | Atención a Clientes |  |  | Atención: | Depto. de Almacén y Logística
Dirección: | País: México |  |  | Dirección: | Avenida Aviación 4304, Zapopan
Tel/Email: | 33 34495988 |  |  | Notas: | Tel: 341 646 1280
Ítem | Código | Descripción | Cantidad | Unidad | Precio Unitario | Importe
1 | 10 k omh | Resistencia | 10 | Pza | $2.00 | $20.00
2 | 4n25 | Optoacoplador | 10 | Pza | $8.00 | $80.00
3 | 1n4007 | Diodo | 10 | Pza | $3.00 | $30.00
4 | 10 mF | Capacitor | 10 | Pza | $4.00 | $40.00
5 | UTP | Cables UTP | 5 | m | $6.00 | $30.00
6 | Calibre 12 | Cable Calibre 12 | 3 | m | $10.00 | $30.00
7 | UTP | Cables UTP | 5 | m | $6.00 | $30.00
8 | Calibre 12 | Cable Calibre 12 | 3 | m | $10.00 | $30.00
 |  |  |  |  | Subtotal: | $290.00
 |  |  |  |  | IVA (16%): | $46.40
Autorizado por: | _________________________ |  |  |  | TOTAL: | $336.40

Sheet: Elf te Motor-Steadywin Official
ORDEN DE COMPRA
CyberSolutions S.A. de C.V. |  |  |  |  | N° de Orden: | OC-2026-010
Avenida Aviación 4304, Zapopan, Jalisco | Av. General Ramon Corona |  |  |  | Fecha: | 20/08/2026
Correo: compras@cybersolutions.com | Tel: 341 646 1280 |  |  |  |  | Términos: | 30 días netos
DATOS DEL PROVEEDOR |  |  |  | ENVIAR A
Empresa: | Elf te Motor-Steadywin Official Store |  |  | Empresa: | CyberSolutions S.A. de C.V.
Atención: | Atención a Clientes |  |  | Atención: | Depto. de Almacén y Logística
Dirección: | País: China |  |  | Dirección: | Avenida Aviación 4304, Zapopan
Tel/Email: | +86 13077918423 |  |  | Notas: | Tel: 341 646 1280
Ítem | Código | Descripción | Cantidad | Unidad | Precio Unitario | Importe
1 | GIM8108-8 | Motor brushless 8NM GIM8108-48 | 3 | Pza | $568.90 | $1706.70
2 | GB3506 | Motor brushless 3NM | 3 | Pza | $483.40 | $1450.20
 |  |  |  |  | Subtotal: | $3156.90
 |  |  |  |  | IVA (16%): | $505.10
Autorizado por: | _________________________ |  |  |  | TOTAL: | $3662.00

Sheet: Steren
ORDEN DE COMPRA
CyberSolutions S.A. de C.V. |  |  |  |  | N° de Orden: | OC-2026-011
Avenida Aviación 4304, Zapopan, Jalisco | Av. General Ramon Corona |  |  |  | Fecha: | 20/08/2026
Correo: compras@cybersolutions.com | Tel: 341 646 1280 |  |  |  |  | Términos: | 30 días netos
DATOS DEL PROVEEDOR |  |  |  | ENVIAR A
Empresa: | Steren |  |  | Empresa: | CyberSolutions S.A. de C.V.
Atención: | Atención a Clientes |  |  | Atención: | Depto. de Almacén y Logística
Dirección: | País: México |  |  | Dirección: | Avenida Aviación 4304, Zapopan
Tel/Email: | 55 1516 6000 |  |  | Notas: | Tel: 341 646 1280
Ítem | Código | Descripción | Cantidad | Unidad | Precio Unitario | Importe
1 | MOT-135 | Servomotor | 1 | Pza | $199.00 | $199.00
 |  |  |  |  | Subtotal: | $199.00
 |  |  |  |  | IVA (16%): | $31.84
Autorizado por: | _________________________ |  |  |  | TOTAL: | $230.84

Sheet: Mar China
ORDEN DE COMPRA
CyberSolutions S.A. de C.V. |  |  |  |  | N° de Orden: | OC-2026-012
Avenida Aviación 4304, Zapopan, Jalisco | Av. General Ramon Corona |  |  |  | Fecha: | 20/08/2026
Correo: compras@cybersolutions.com | Tel: 341 646 1280 |  |  |  |  | Términos: | 30 días netos
DATOS DEL PROVEEDOR |  |  |  | ENVIAR A
Empresa: | Mar China |  |  | Empresa: | CyberSolutions S.A. de C.V.
Atención: | Atención a Clientes |  |  | Atención: | Depto. de Almacén y Logística
Dirección: | País: México |  |  | Dirección: | Avenida Aviación 4304, Zapopan
Tel/Email: | 33 3620 8756 |  |  | Notas: | Tel: 341 646 1280
Ítem | Código | Descripción | Cantidad | Unidad | Precio Unitario | Importe
1 | Aluminio 6061 | Solera de alumino | 4 | ''x14''x1/4'' | $680.22 | $2720.88
 |  |  |  |  | Subtotal: | $2720.88
 |  |  |  |  | IVA (16%): | $435.34
Autorizado por: | _________________________ |  |  |  | TOTAL: | $3156.22

Sheet: Lizar
ORDEN DE COMPRA
CyberSolutions S.A. de C.V. |  |  |  |  | N° de Orden: | OC-2026-013
Avenida Aviación 4304, Zapopan, Jalisco | Av. General Ramon Corona |  |  |  | Fecha: | 20/08/2026
Correo: compras@cybersolutions.com | Tel: 341 646 1280 |  |  |  |  | Términos: | 30 días netos
DATOS DEL PROVEEDOR |  |  |  | ENVIAR A
Empresa: | Lizar |  |  | Empresa: | CyberSolutions S.A. de C.V.
Atención: | Atención a Clientes |  |  | Atención: | Depto. de Almacén y Logística
Dirección: | País: México |  |  | Dirección: | Avenida Aviación 4304, Zapopan
Tel/Email: | 33 3124 5228 |  |  | Notas: | Tel: 341 646 1280
Ítem | Código | Descripción | Cantidad | Unidad | Precio Unitario | Importe
1 | Allen | tornillos | 40 | Pza | $5.00 | $200.00
 |  |  |  |  | Subtotal: | $200.00
 |  |  |  |  | IVA (16%): | $32.00
Autorizado por: | _________________________ |  |  |  | TOTAL: | $232.00
