Omrover/MoMa-robot/(list of files, cad)

Other CAD files:
docs/Diseños CAD/Dibujos 2D/Brazo 1GDL - 3GDL/base_movil_brazo.SLDDRW
docs/Diseños CAD/Dibujos 2D/Brazo 1GDL - 3GDL/separador_4GDL.SLDDRW
docs/Diseños CAD/Dibujos 2D/Brazo 1GDL - 3GDL/sujecion_frontal_1GDL.SLDDRW
docs/Diseños CAD/Dibujos 2D/Brazo 1GDL - 3GDL/sujecion_motor_L.SLDDRW
docs/Diseños CAD/Dibujos 2D/Brazo 1GDL - 3GDL/sujecion_trasera_1GDL.SLDDRW
docs/Diseños CAD/Dibujos 2D/cople_rodamiento_motor.SLDDRW
docs/Diseños CAD/Dibujos 2D/lamina_paleta_calibre14.SLDDRW
docs/Diseños CAD/Dibujos 2D/separador_1GDL.SLDDRW
docs/Diseños CAD/Dibujos 2D/solera_motor_motor.SLDDRW
docs/Diseños CAD/Dibujos 2D/sujecion_frontal_motor.SLDDRW
docs/Diseños CAD/Dibujos 2D/sujecion_trasera_motor.SLDDRW
docs/Diseños CAD/Dibujos 2D/tubo_aluminio_2GDL.SLDDRW
docs/Diseños CAD/Dibujos 2D/union_motor_calibre14.SLDDRW
