Omrover/MoMa-robot/docs/Diseños CAD/Dibujos 2D/Brazo_4GDL.pdf

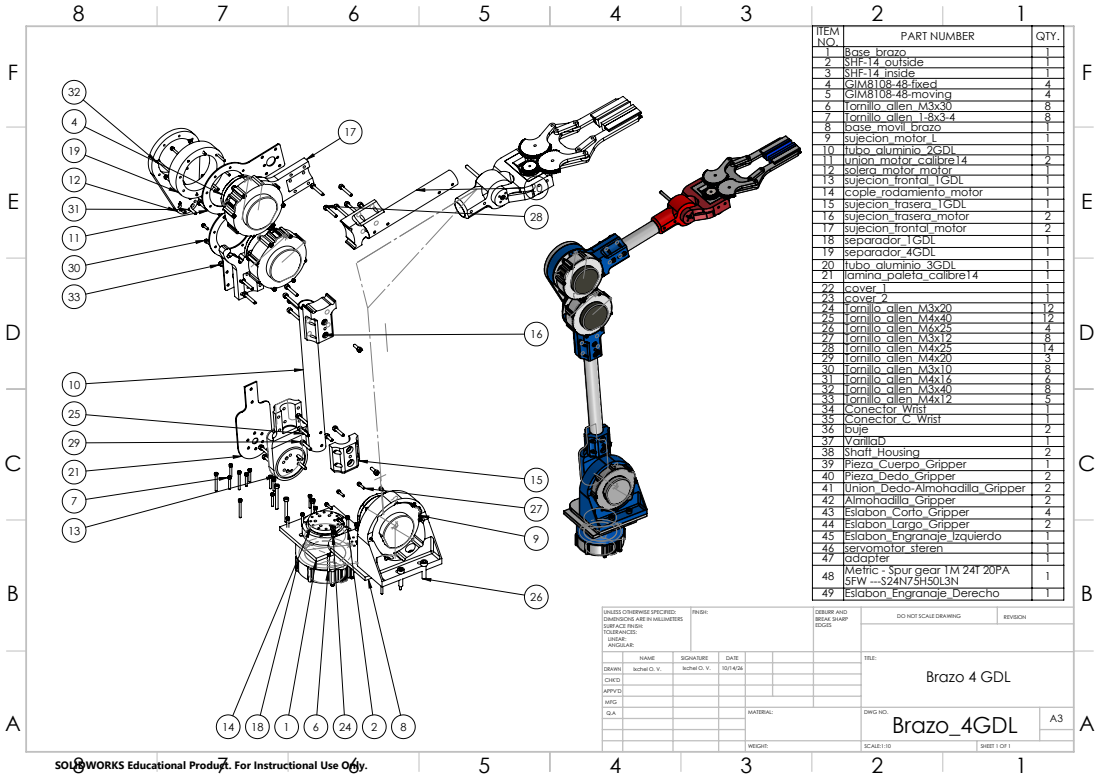
[picture p3: page 1]
PART NUMBER; QTY. 1 Base_brazo; 1 2 SHF-14_outside; 1 3 SHF-14_inside; 1 4 GIM8108-48-fixed; 4 5 GIM8108-48-moving; 4 6 Tornillo_allen_M3x30; 8 7 Tornillo_allen_1-8x3-4; 8 8 base_movil_brazo; 1 9 sujecion_motor_L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

UNLESS OTHERWISE SPECIFIED:
DIMENSIONS ARE IN MILLIMETERS
SURFACE FINISH:
TOLERANCES:
LINEAR:
ANGULAR:

NAME | SIGNATURE | DATE | | | | TITLE: Brazo 4 GDL

DRAWN | Ixchel O. V. | Ixchel O. V. | 10/14/26
CHK'D
APPV'D
MFG
Q.A | | | | MATERIAL: | DWG NO. Brazo_4GDL | A3

SOLIDWORKS Educational Product. For Instructional Use Only.
