Omrover/MoMa-robot/docs/Diseños CAD/Dibujos 2D/Conector_C_Wrist.pdf

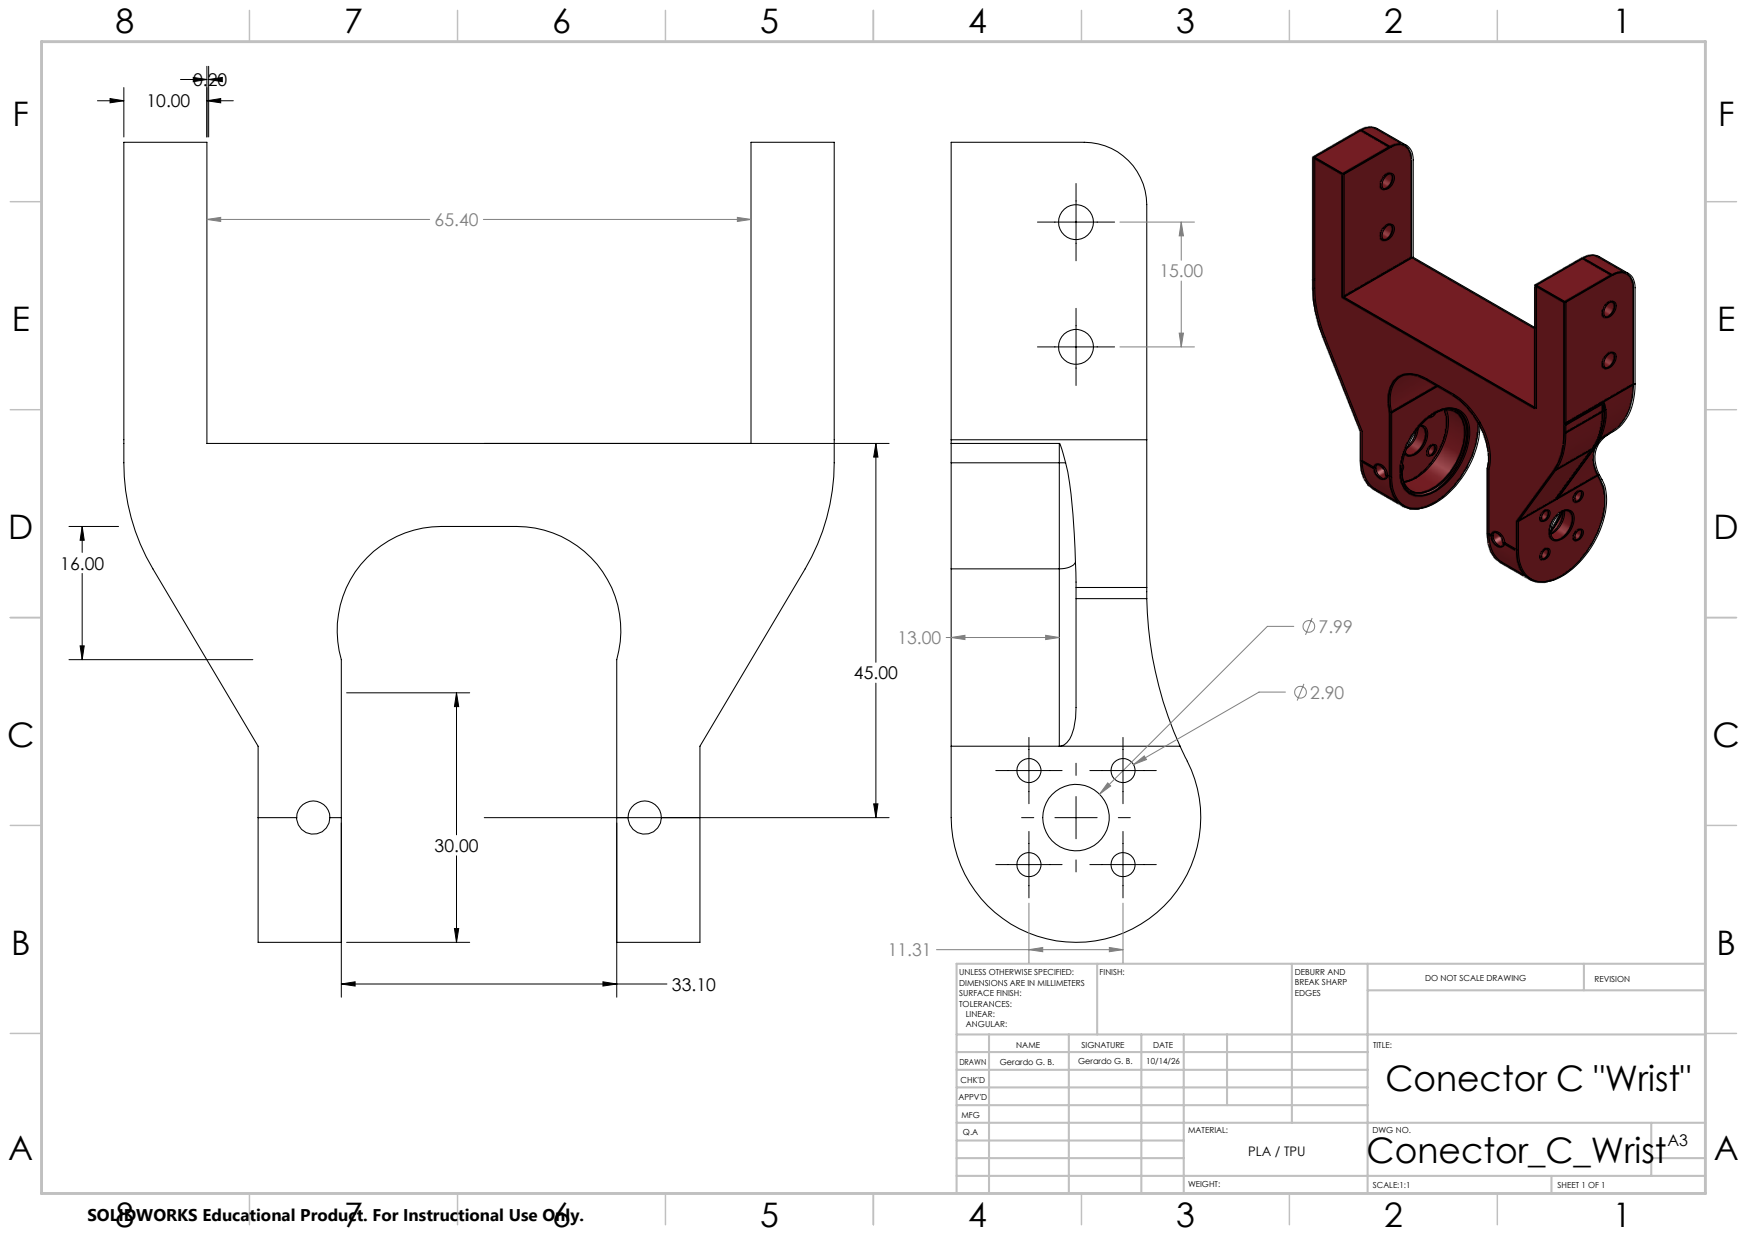
[picture p5: page 1]
FINISH:; DEBURR AND; BREAK SHARP; DO NOT SCALE DRAWING; REVISION; SCALE:1:1; SHEET 1 OF 1

UNLESS OTHERWISE SPECIFIED:
DIMENSIONS ARE IN MILLIMETERS
SURFACE FINISH:
TOLERANCES:
LINEAR:
ANGULAR:

NAME | SIGNATURE | DATE | | | | TITLE: Conector C "Wrist"

DRAWN | Gerardo G. B. | Gerardo G. B. | 10/14/26
CHK'D
APPV'D
MFG
Q.A | | | | MATERIAL: | DWG NO. Conector_C_Wrist | A3 PLA / TPU

SOLIDWORKS Educational Product. For Instructional Use Only.
