Omrover/MoMa-robot/docs/Diseños CAD/Dibujos 2D/Conector_Wrist.pdf

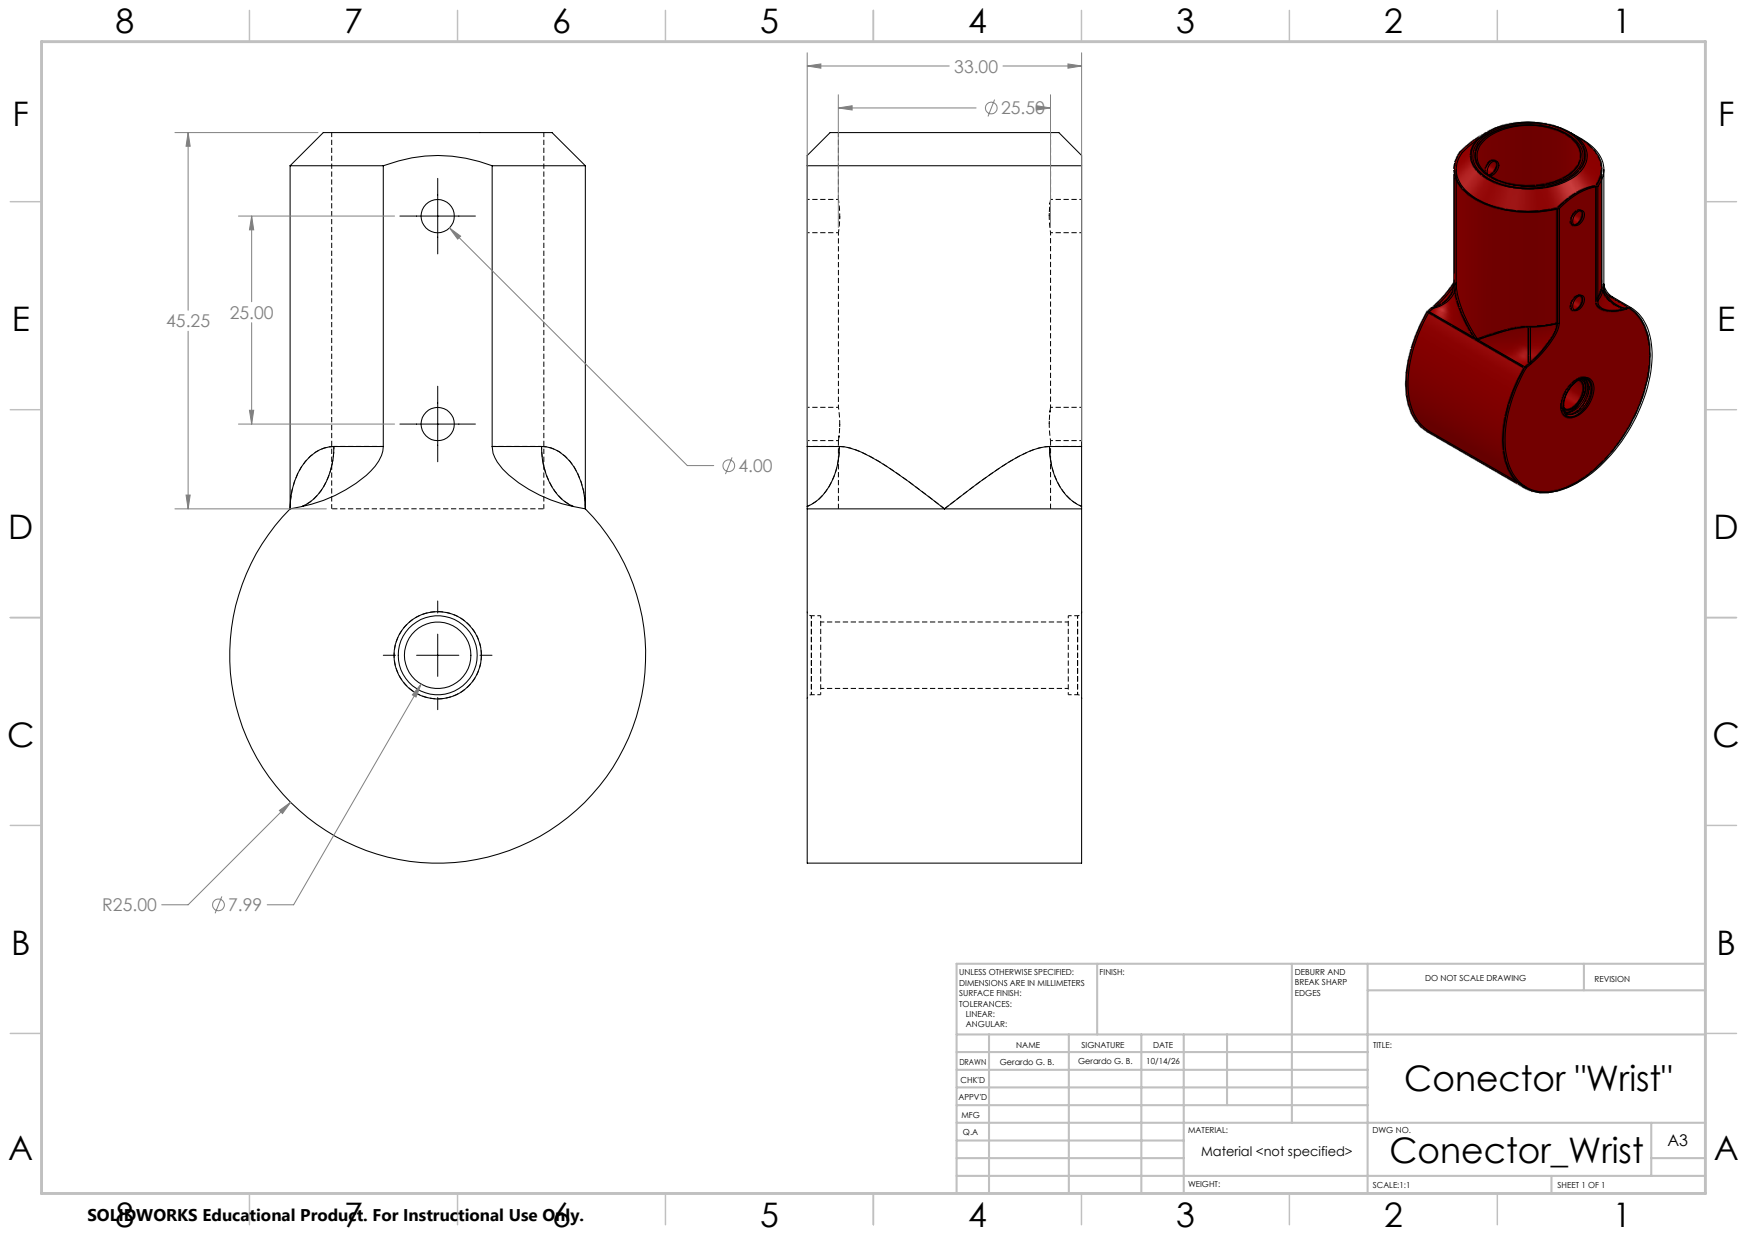
[picture p6: page 1]
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

UNLESS OTHERWISE SPECIFIED:
DIMENSIONS ARE IN MILLIMETERS
SURFACE FINISH:
TOLERANCES:
LINEAR:
ANGULAR:

NAME | SIGNATURE | DATE | | | | TITLE: Conector "Wrist"

DRAWN | Gerardo G. B. | Gerardo G. B. | 10/14/26
CHK'D
APPV'D
MFG
Q.A | | | | MATERIAL: | DWG NO. Conector_Wrist | A3 Material <not specified>

SOLIDWORKS Educational Product. For Instructional Use Only.
