Omrover/MoMa-robot/docs/Diseños CAD/Dibujos 2D/Eslabon_Engranaje_Izquierdo.pdf

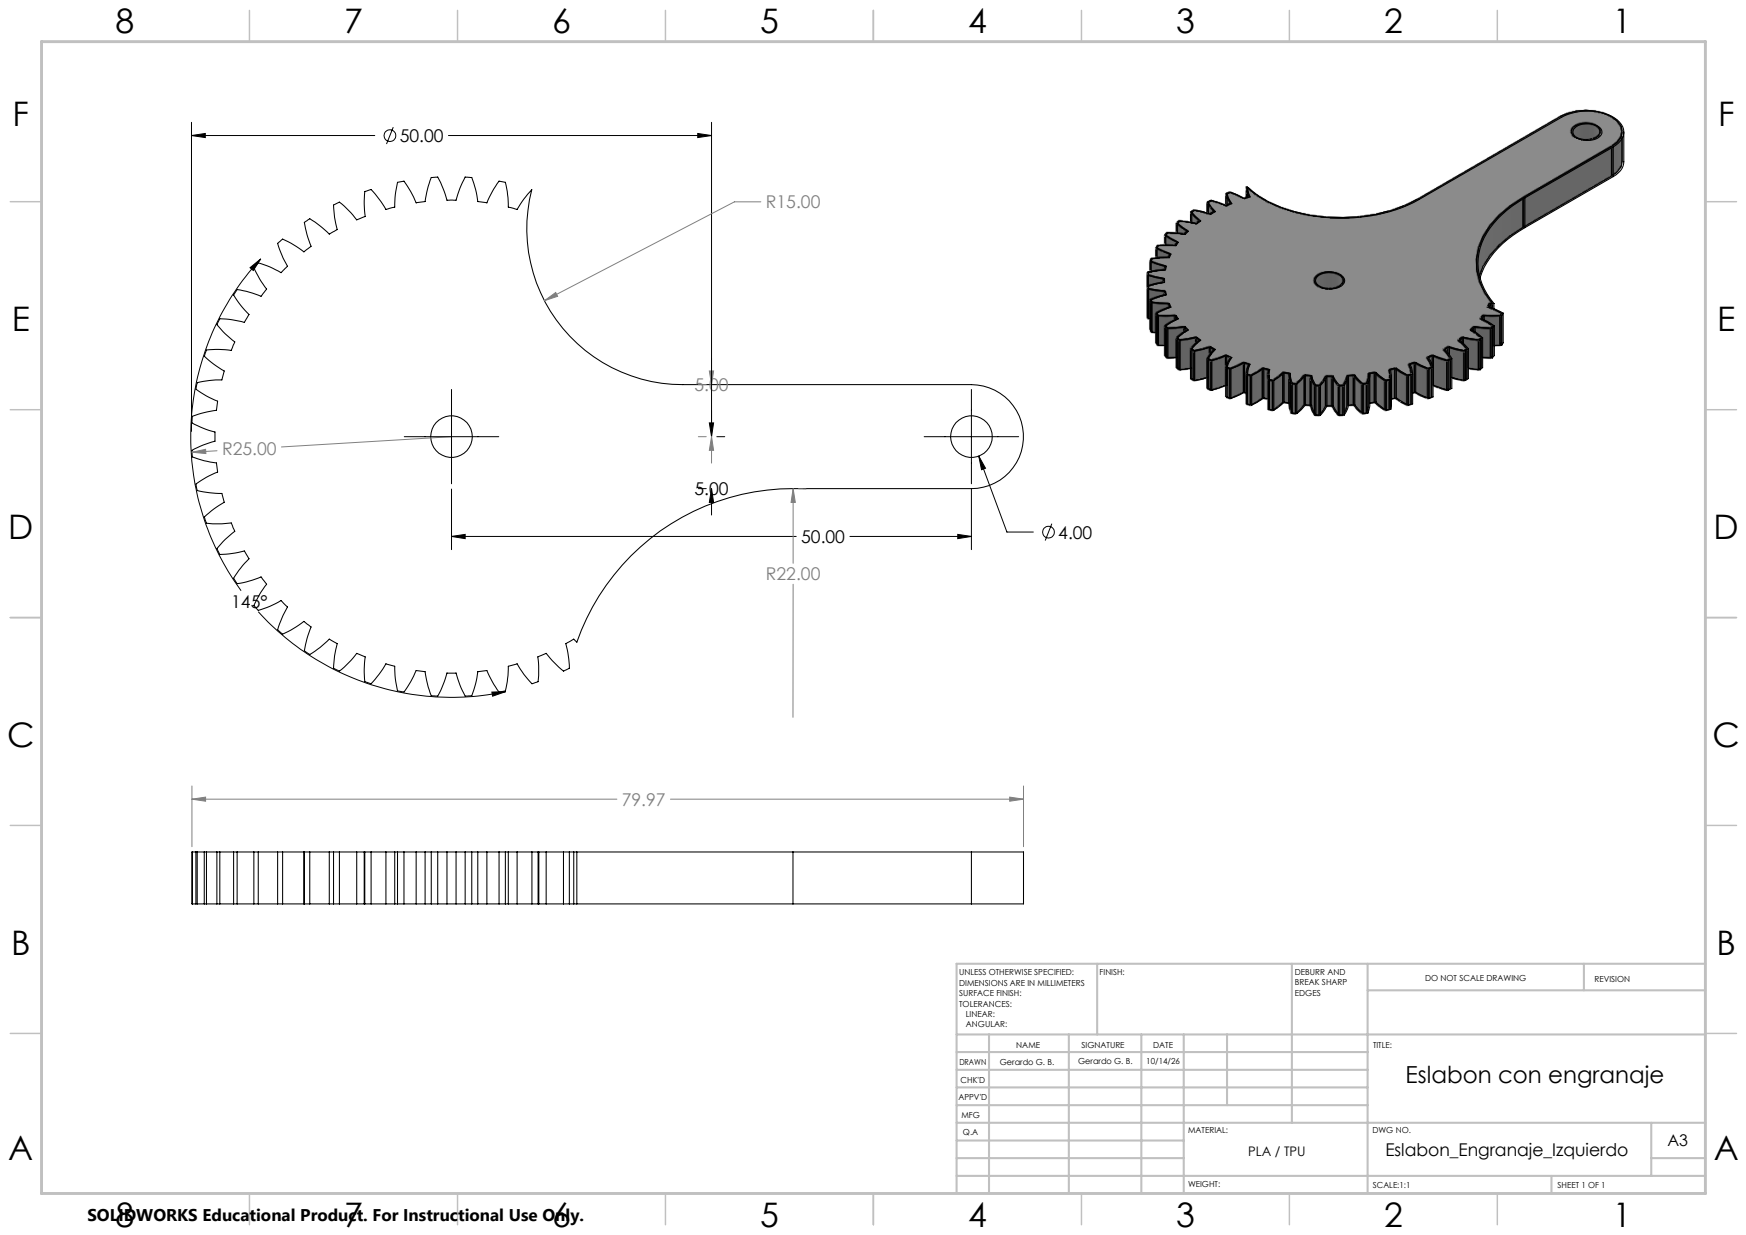
[picture p7: page 1]
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

UNLESS OTHERWISE SPECIFIED:
DIMENSIONS ARE IN MILLIMETERS
SURFACE FINISH:
TOLERANCES:
LINEAR:
ANGULAR:

NAME | SIGNATURE | DATE | | | | TITLE: Eslabon con engranaje

DRAWN | Gerardo G. B. | Gerardo G. B. | 10/14/26
CHK'D
APPV'D
MFG
Q.A | | | | MATERIAL: | DWG NO. Eslabon_Engranaje_Izquierdo | A3 PLA / TPU

SOLIDWORKS Educational Product. For Instructional Use Only.
