Omrover/MoMa-robot/docs/Diseños CAD/Dibujos 2D/solera_motor_motor.pdf

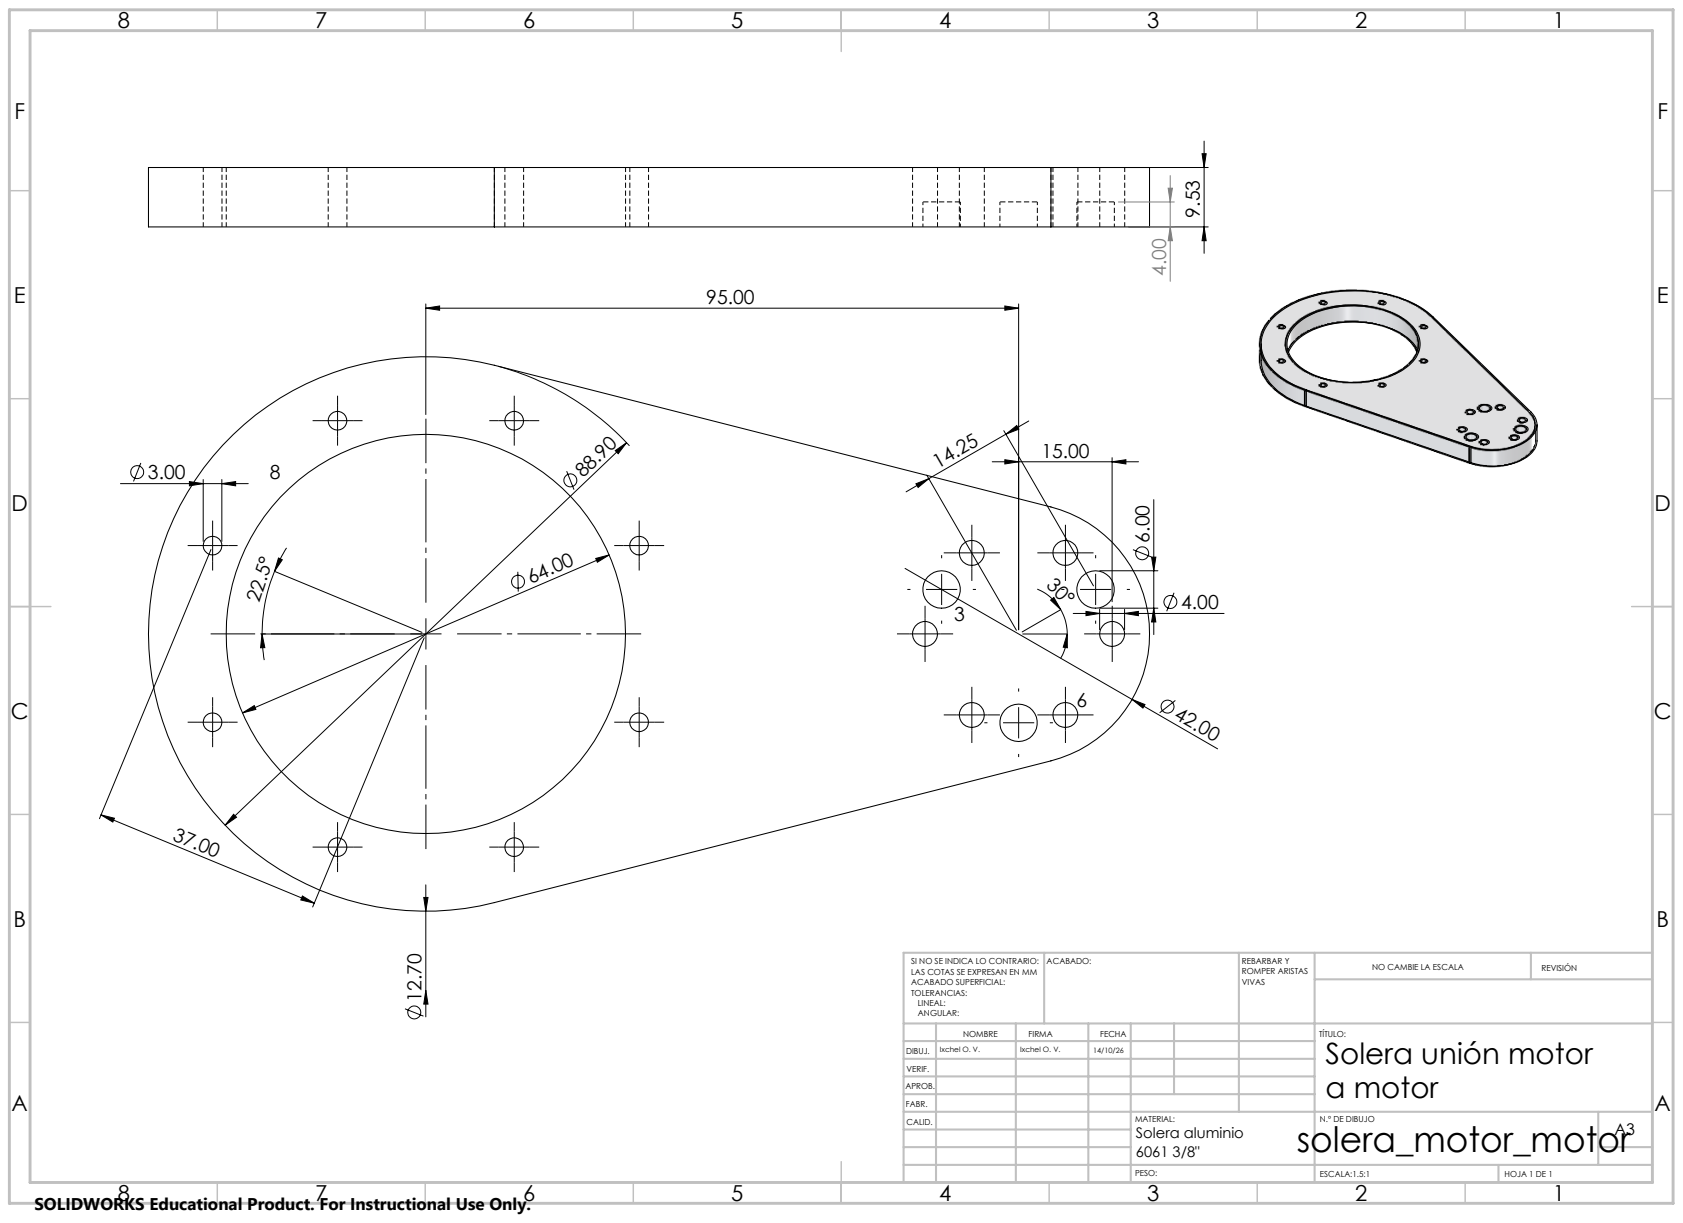
[picture p8: page 1]
a motor A; ACABADO:; REBARBAR Y; ROMPER ARISTAS; NO CAMBIE LA ESCALA; REVISIÓN; ESCALA:1.5:1; HOJA 1 DE 1

SI NO SE INDICA LO CONTRARIO:
LAS COTAS SE EXPRESAN EN MM
ACABADO SUPERFICIAL:
TOLERANCIAS:
LINEAL:
ANGULAR:

DIBUJ. | Ixchel O. V. | Ixchel O. V. | 14/10/26

NOMBRE | FIRMA | FECHA | | | | TÍTULO: Solera unión motor

VERIF.
APROB.
FABR.
CALID. | | | | MATERIAL: solera_motor_motor Solera aluminio 6061 3/8" | N.º DE DIBUJO | A3

SOLIDWORKS Educational Product. For Instructional Use Only.
