Omrover/MoMa-robot/docs/Diseños CAD/Dibujos 2D/sujecion_frontal_motor.pdf

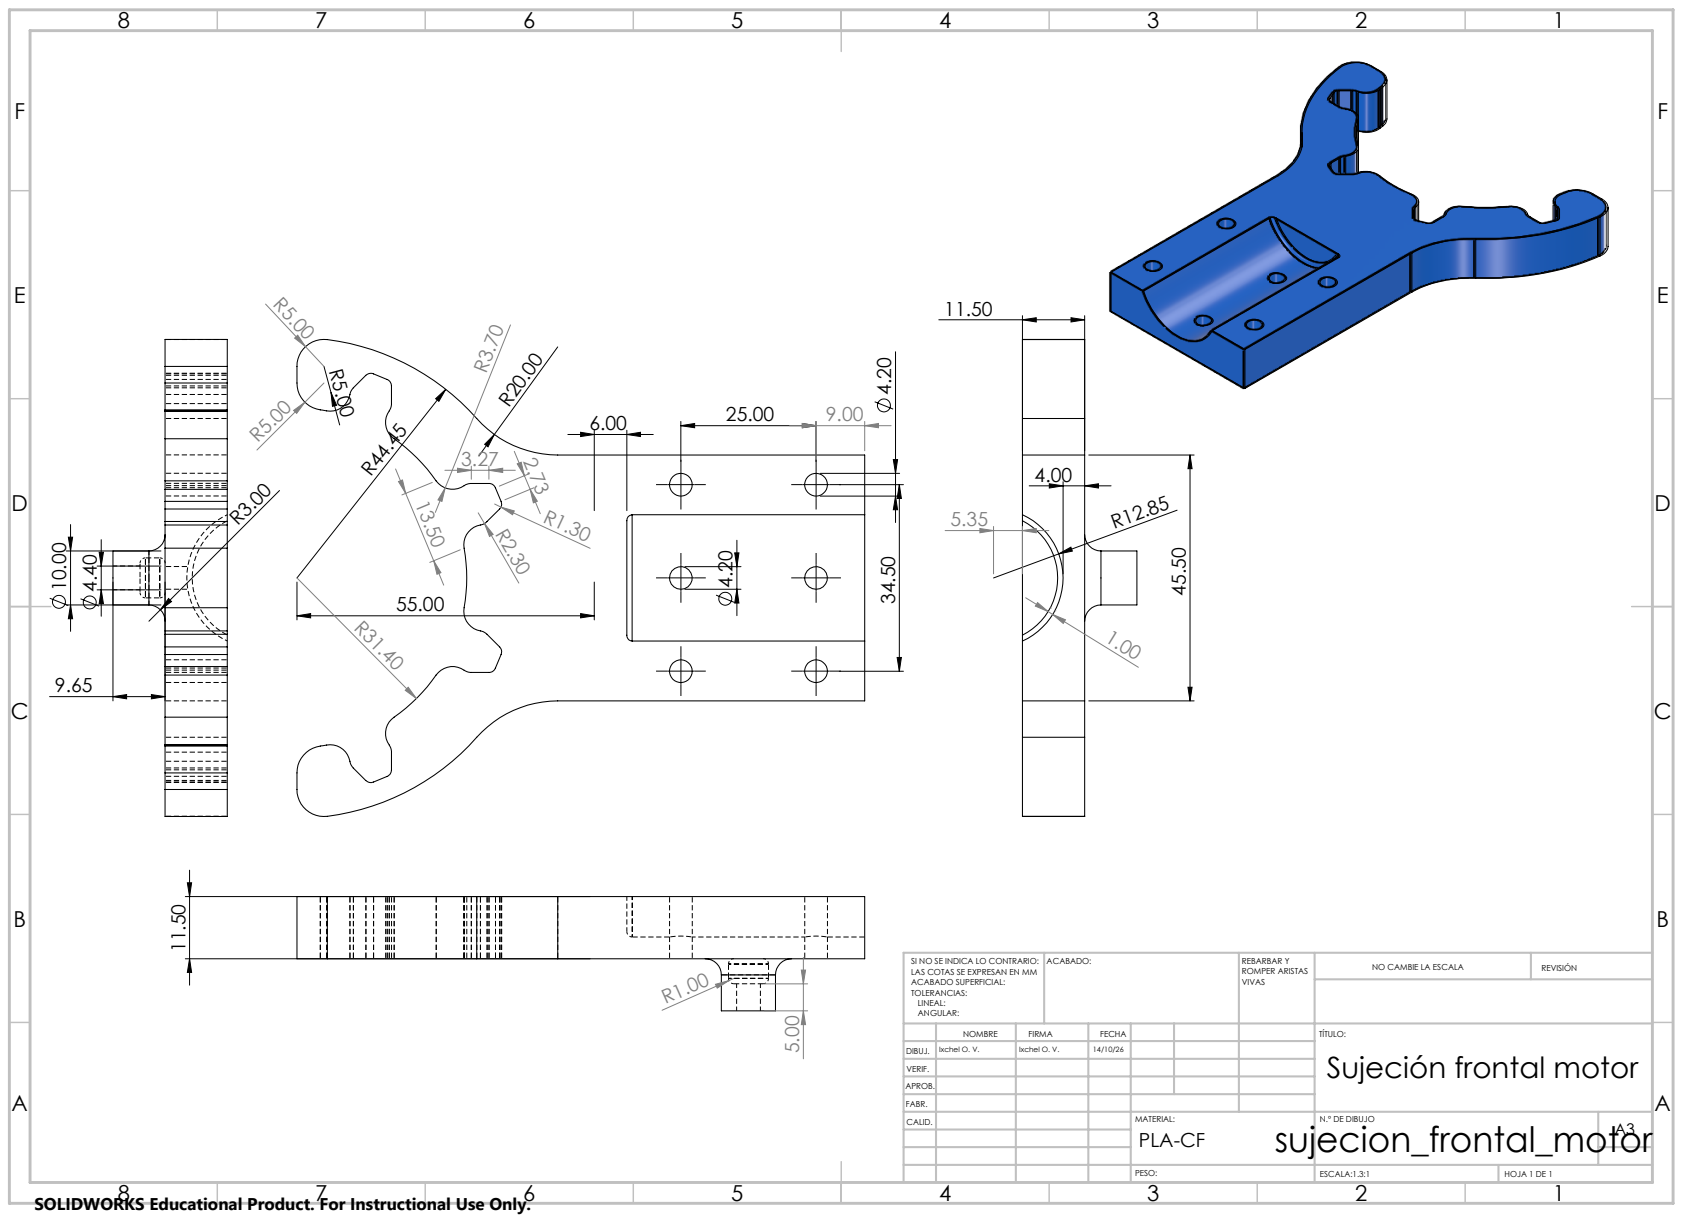
[picture p9: page 1]
ACABADO:; REBARBAR Y; ROMPER ARISTAS; NO CAMBIE LA ESCALA; REVISIÓN; ESCALA:1.3:1; HOJA 1 DE 1

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

NOMBRE | FIRMA | FECHA | | | | TÍTULO: Sujeción frontal motor

DIBUJ. | Ixchel O. V. | Ixchel O. V. | 14/10/26
VERIF.
APROB.
FABR.
CALID. | | | | MATERIAL: sujecion_frontal_motor PLA-CF | N.º DE DIBUJO | A3

SOLIDWORKS Educational Product. For Instructional Use Only.
