Omrover/MoMa-robot/docs/Diseños CAD/Dibujos 2D/sujecion_motor_L.pdf

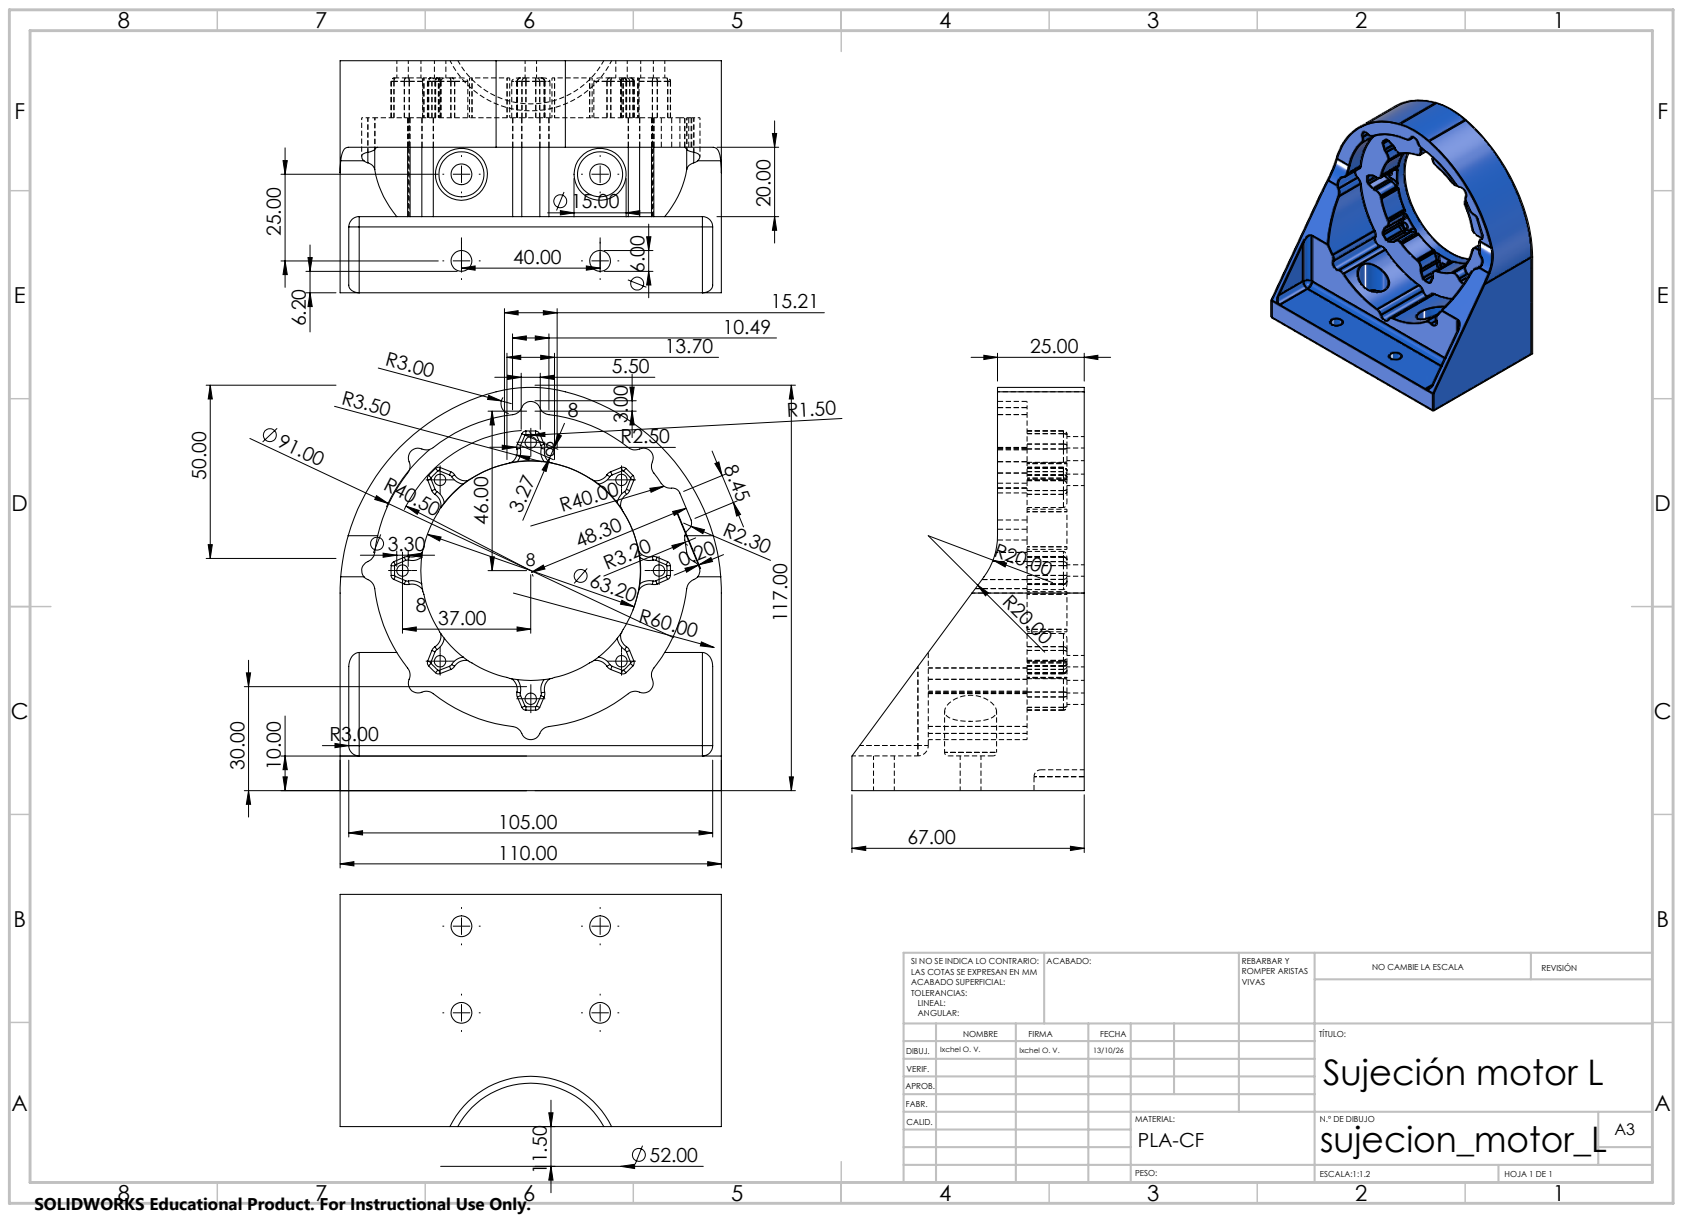
[picture p10: page 1]
ACABADO:; REBARBAR Y; ROMPER ARISTAS; NO CAMBIE LA ESCALA; REVISIÓN; ESCALA:1:1.2; HOJA 1 DE 1

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

NOMBRE | FIRMA | FECHA | | | | TÍTULO:

VERIF. | | Ixchel O. V. | 13/10/26 | | | | Sujeción motor L Ixchel O. V.
DIBUJ.

APROB.
FABR.
CALID. | | | | MATERIAL: PLA-CF | N.º DE DIBUJO sujecion_motor_L | A3

SOLIDWORKS Educational Product. For Instructional Use Only.
