Omrover/MoMa-robot/docs/Diseños CAD/Dibujos 2D/sujecion_trasera_motor.pdf

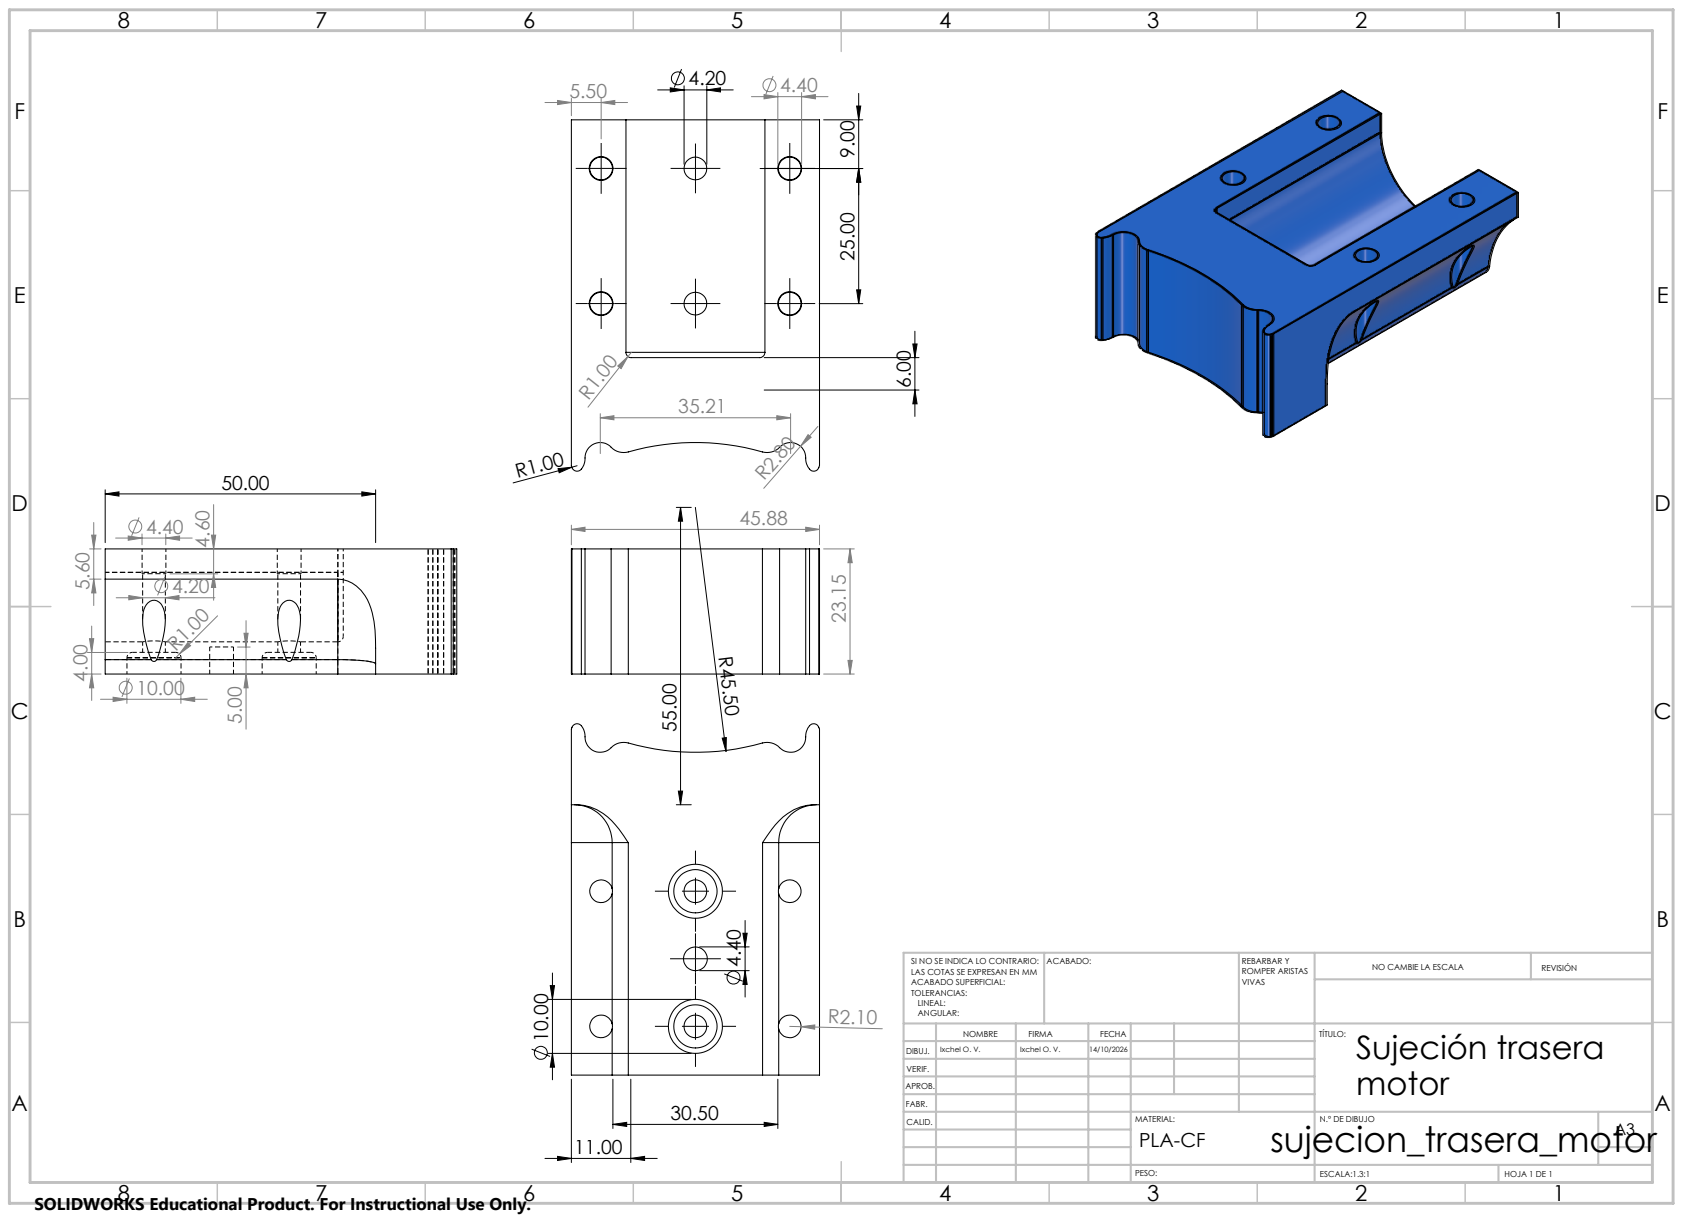
[picture p11: page 1]
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

NOMBRE | FIRMA | FECHA | | | | Sujeción trasera TÍTULO: motor

DIBUJ. | Ixchel O. V. | Ixchel O. V. | 14/10/2026
VERIF.
APROB.
FABR.
CALID. | | | | MATERIAL: sujecion_trasera_motor PLA-CF | N.º DE DIBUJO | A3

SOLIDWORKS Educational Product. For Instructional Use Only.
