Omrover/MoMa-robot/docs/Diseños CAD/Dibujos 2D/union_motor_calibre14.pdf

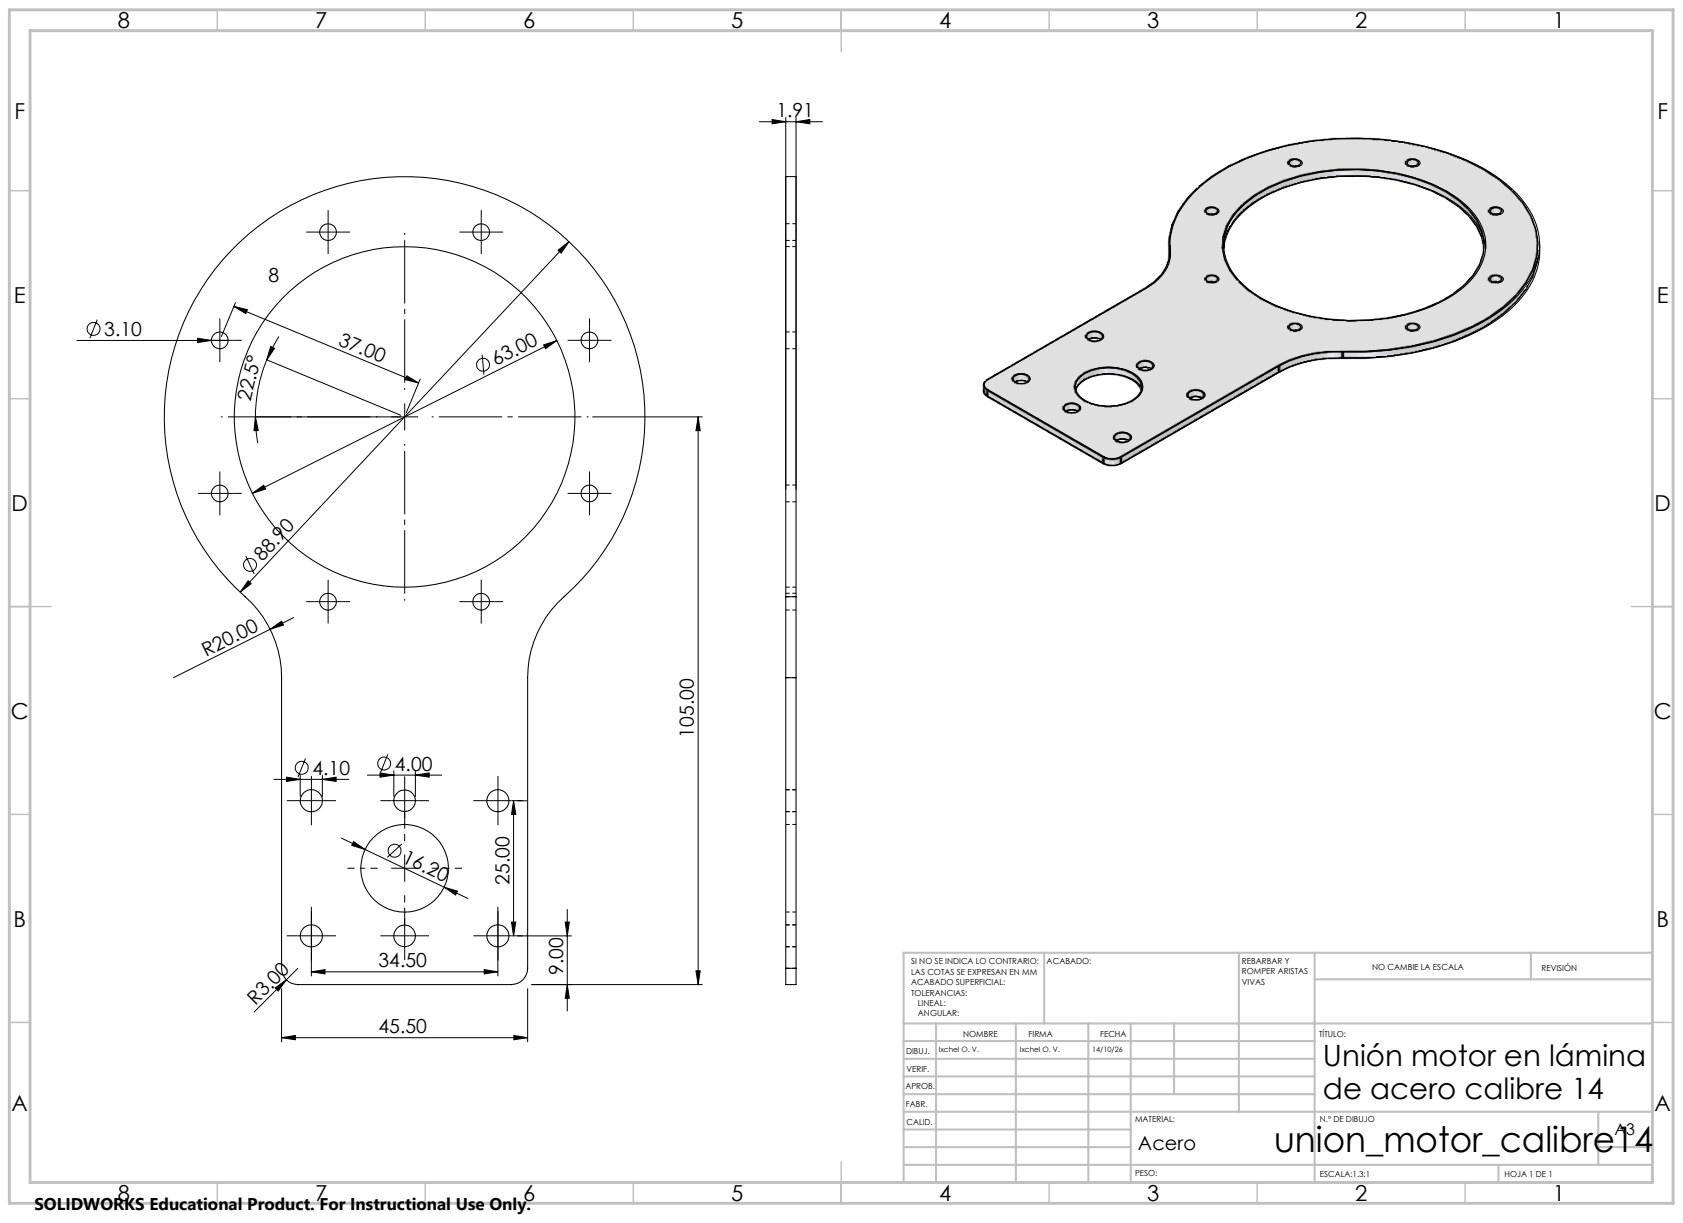
[picture p12: page 1]
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

NOMBRE | FIRMA | FECHA | | | | TÍTULO: Unión motor en lámina de acero calibre 14

DIBUJ. | Ixchel O. V. | Ixchel O. V. | 14/10/26
VERIF.
APROB.
FABR.
CALID. | | | | MATERIAL: union_motor_calibre14 Acero | N.º DE DIBUJO | A3

SOLIDWORKS Educational Product. For Instructional Use Only.
