Omrover/MoMa-robot/docs/Diseños CAD/Dibujos 2D/base_movil_brazo.pdf

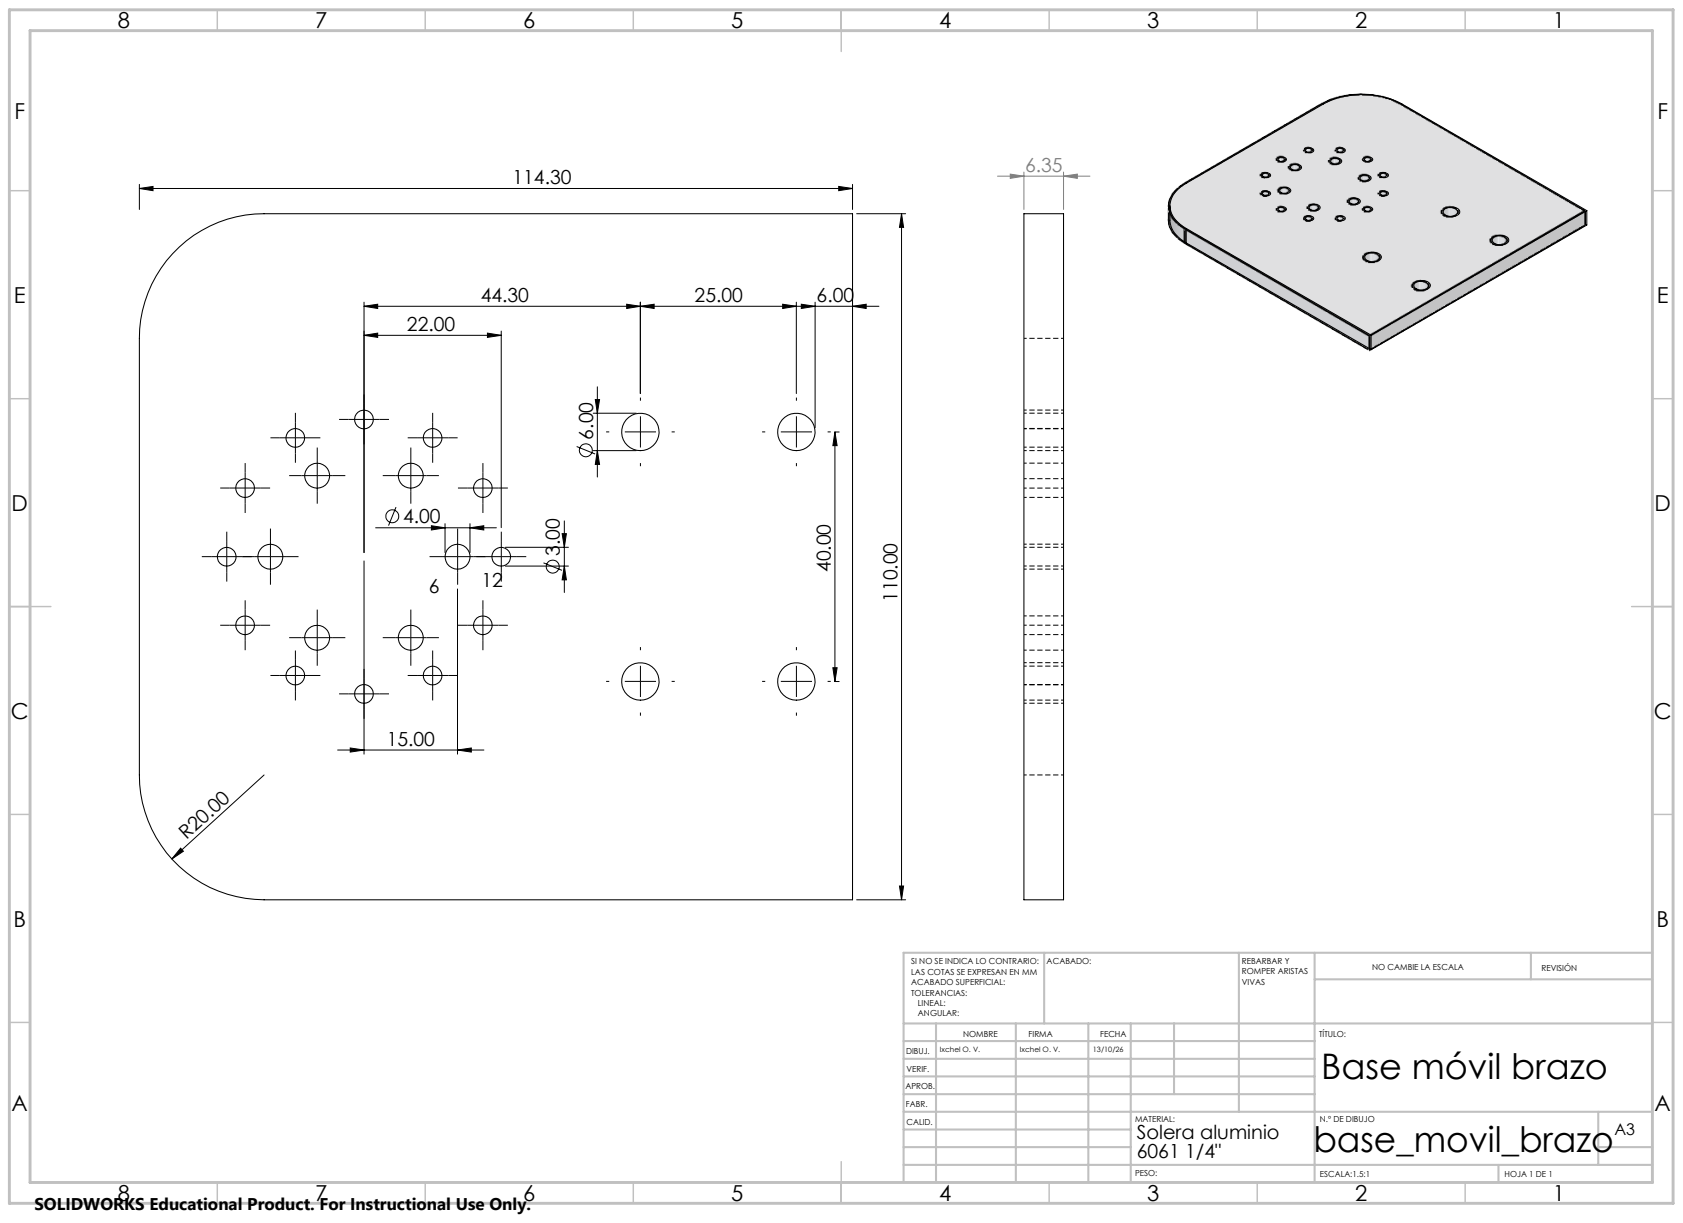
[picture p13: page 1]
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

NOMBRE | FIRMA | FECHA | | | | TÍTULO:

DIBUJ. | | Ixchel O. V. | 13/10/26 | | | | Base móvil brazo Ixchel O. V.
VERIF.
APROB.
FABR.
CALID. | | | | MATERIAL: Solera aluminio 6061 1/4" | N.º DE DIBUJO base_movil_brazo | A3

SOLIDWORKS Educational Product. For Instructional Use Only.
