Omrover/MoMa-robot/docs/Diseños CAD/Dibujos 2D/cople_rodamiento_motor.pdf

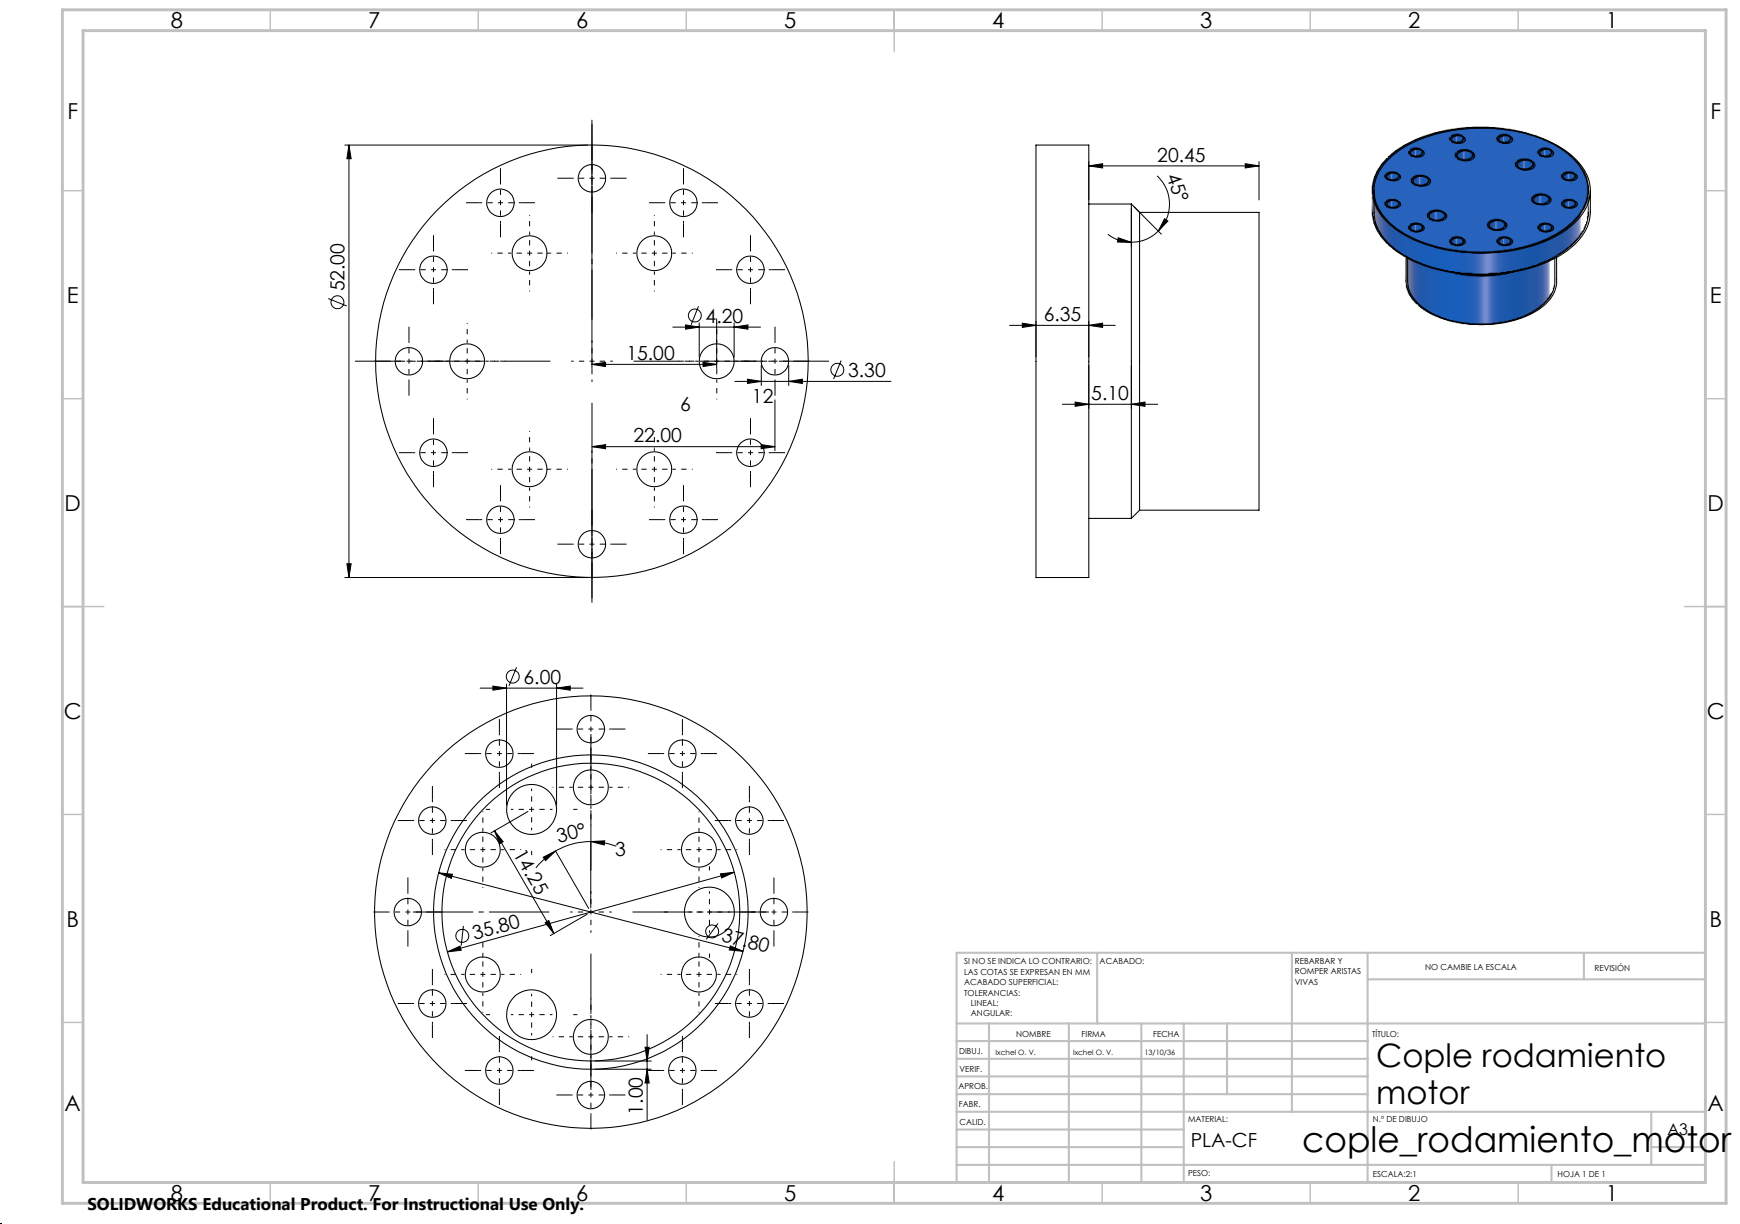
[picture p14: page 1]
ACABADO:; REBARBAR Y; ROMPER ARISTAS; NO CAMBIE LA ESCALA; REVISIÓN; ESCALA:2:1; HOJA 1 DE 1

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

NOMBRE | FIRMA | FECHA | | | | TÍTULO: Cople rodamiento

DIBUJ. | Ixchel O. V. | Ixchel O. V. | 13/10/36
VERIF.
APROB.
FABR.
CALID. | | | | MATERIAL: PLA-CF | N.º DE DIBUJO | A3

SOLIDWORKS Educational Product. For Instructional Use Only.
