Omrover/MoMa-robot/docs/Diseños CAD/Dibujos 2D/lamina_paleta_calibre14.pdf

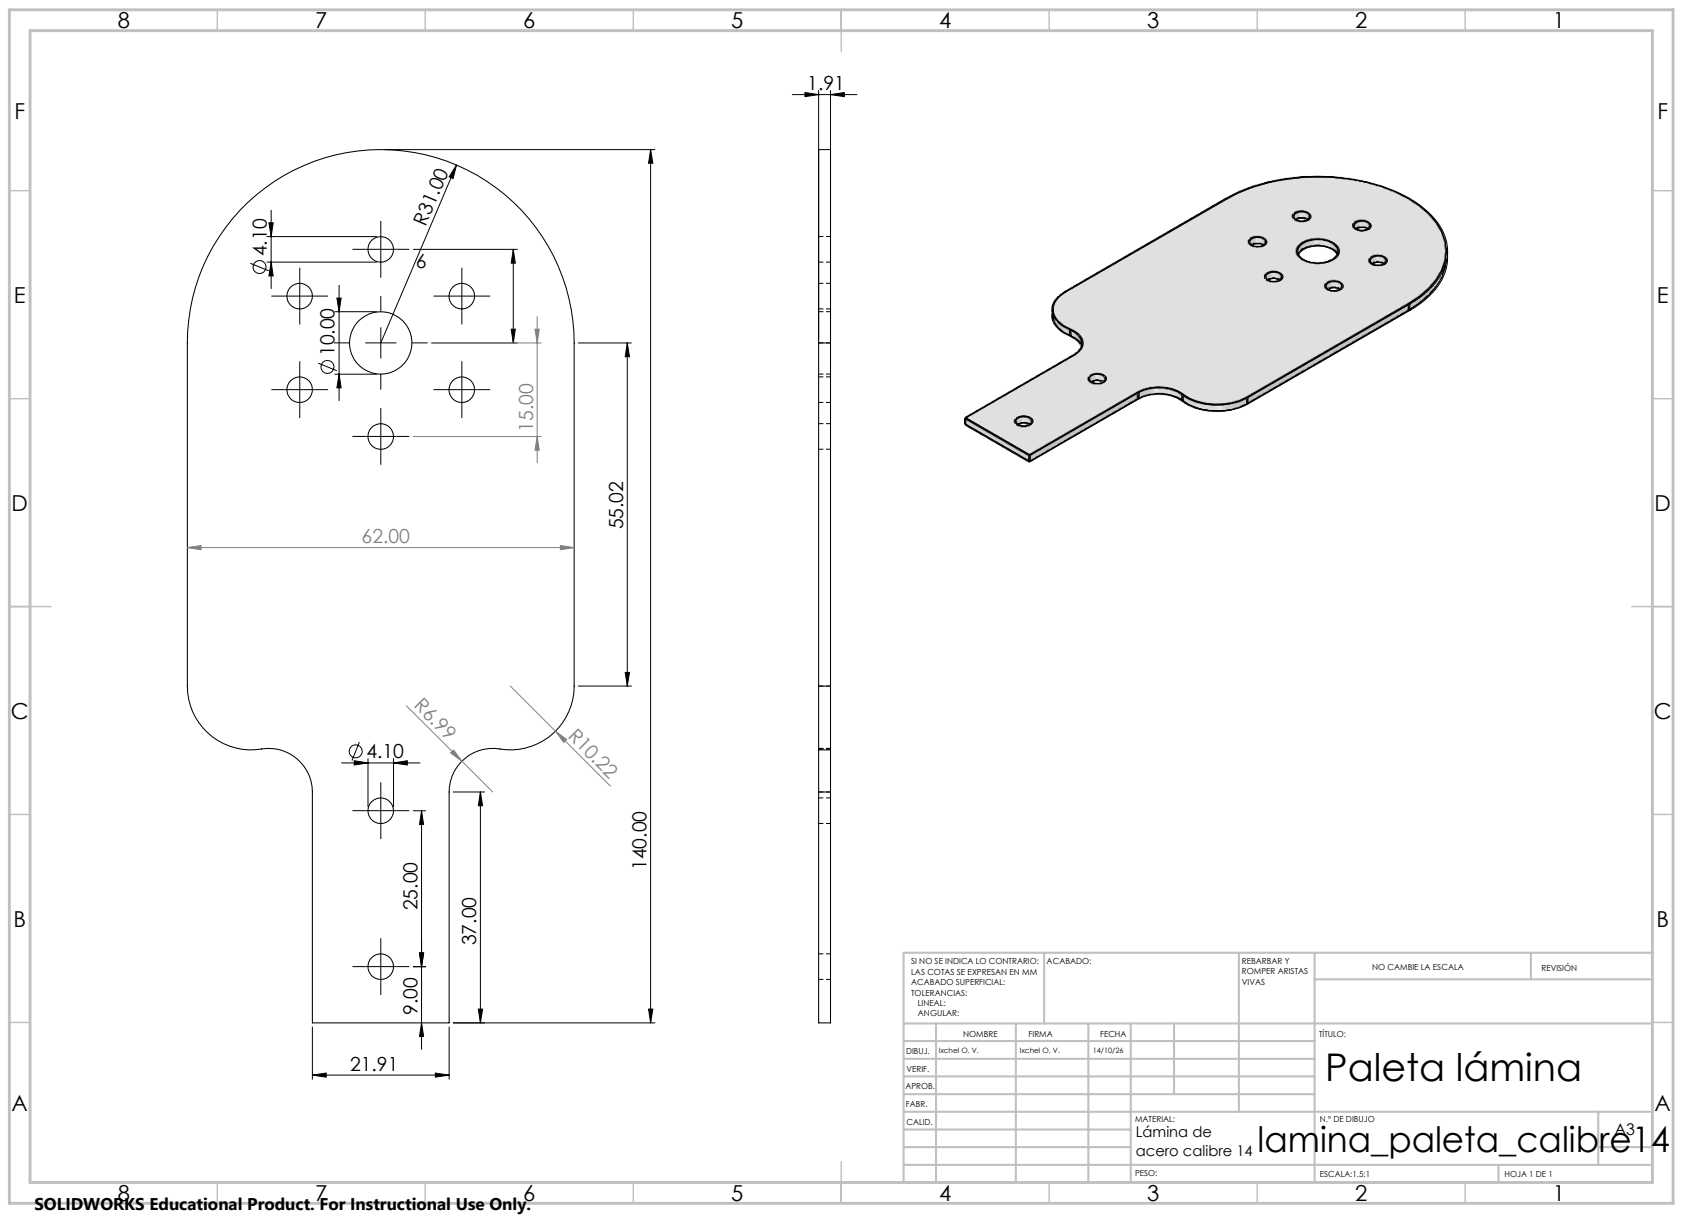
[picture p15: page 1]
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

NOMBRE | FIRMA | FECHA | | | | TÍTULO:

DIBUJ. | | Ixchel O. V. | 14/10/26 | | | | Paleta lámina Ixchel O. V.

VERIF.
APROB.
FABR.
CALID. | | | | MATERIAL: lamina_paleta_calibre14 Lámina de acero calibre 14 | N.º DE DIBUJO | A3

SOLIDWORKS Educational Product. For Instructional Use Only.
