Omrover/MoMa-robot/docs/Diseños CAD/Dibujos 2D/separador_1GDL.pdf

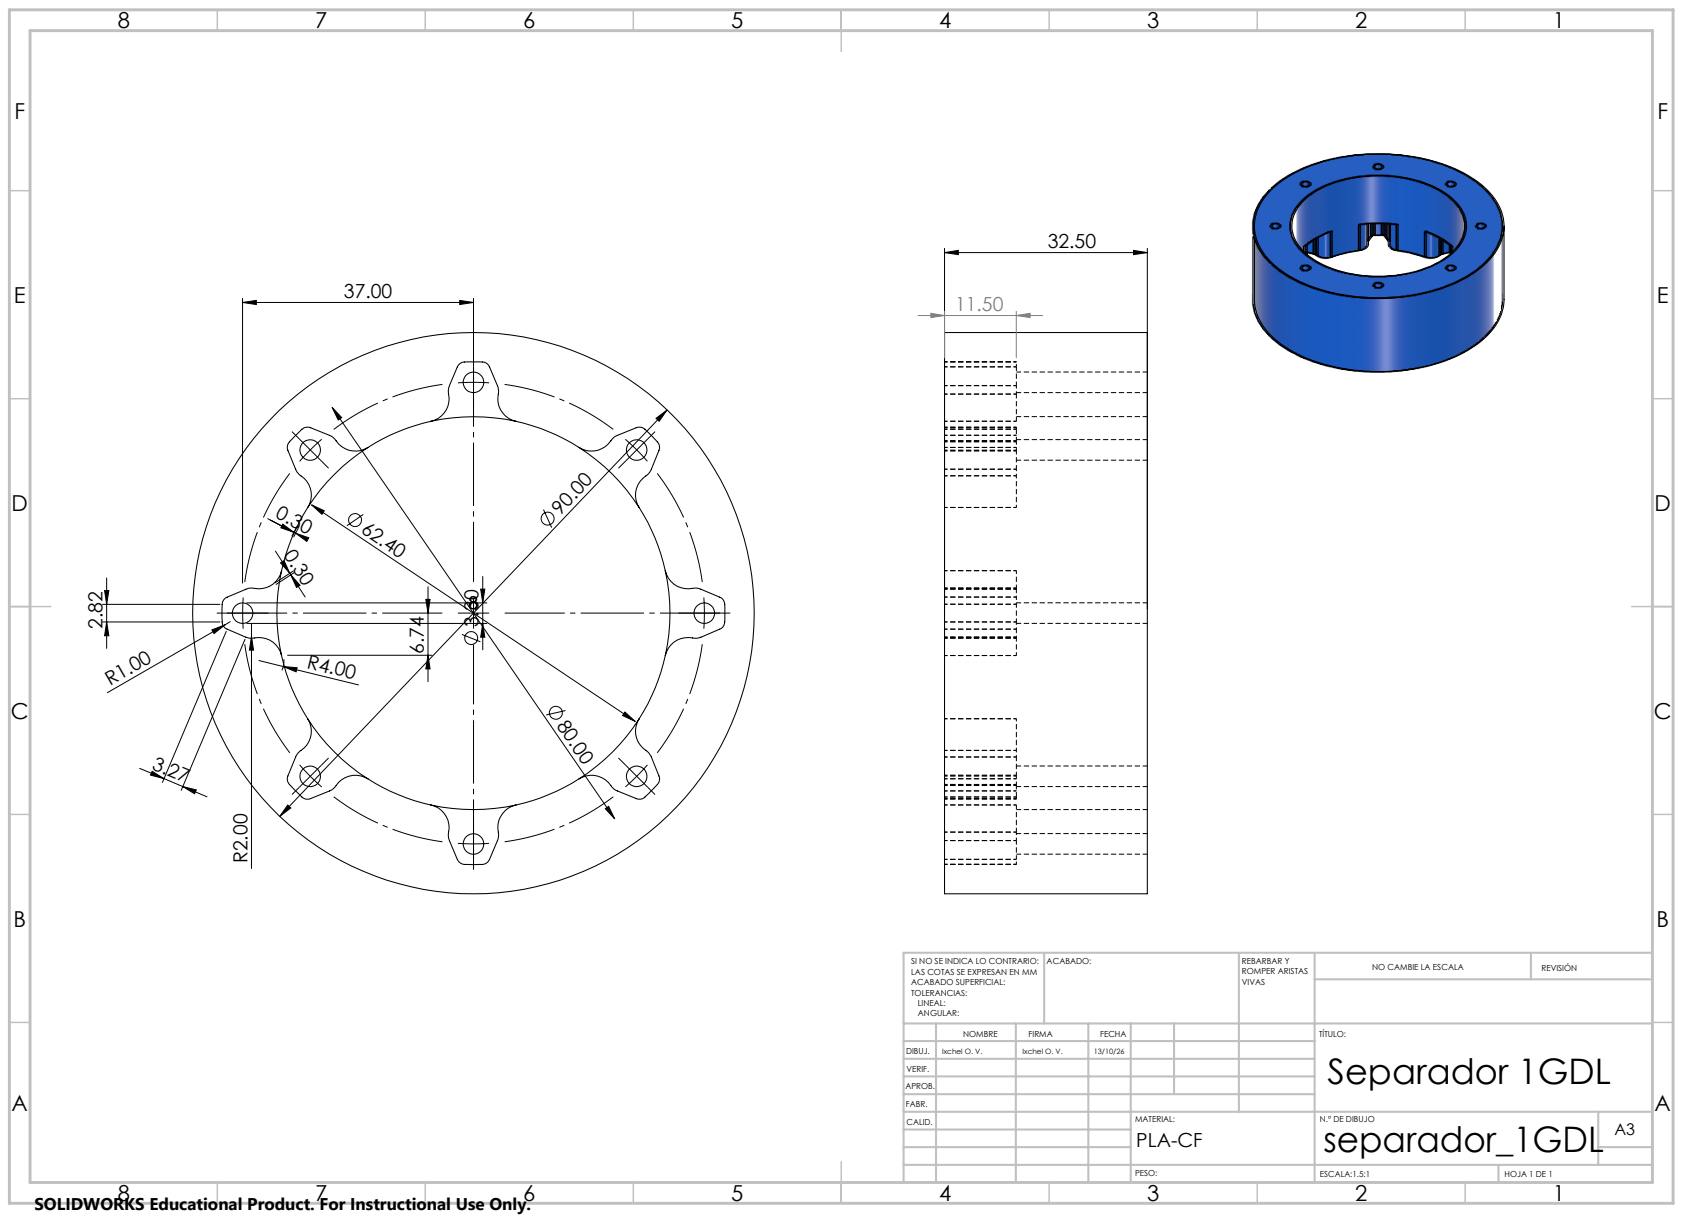
[picture p16: page 1]
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

NOMBRE | FIRMA | FECHA | | | | TÍTULO: Separador 1GDL

DIBUJ. | Ixchel O. V. | Ixchel O. V. | 13/10/26
VERIF.
APROB.
FABR.
CALID. | | | | MATERIAL: PLA-CF | N.º DE DIBUJO separador_1GDL | A3

SOLIDWORKS Educational Product. For Instructional Use Only.
