Omrover/MoMa-robot/docs/Diseños CAD/Dibujos 2D/separador_4GDL.pdf

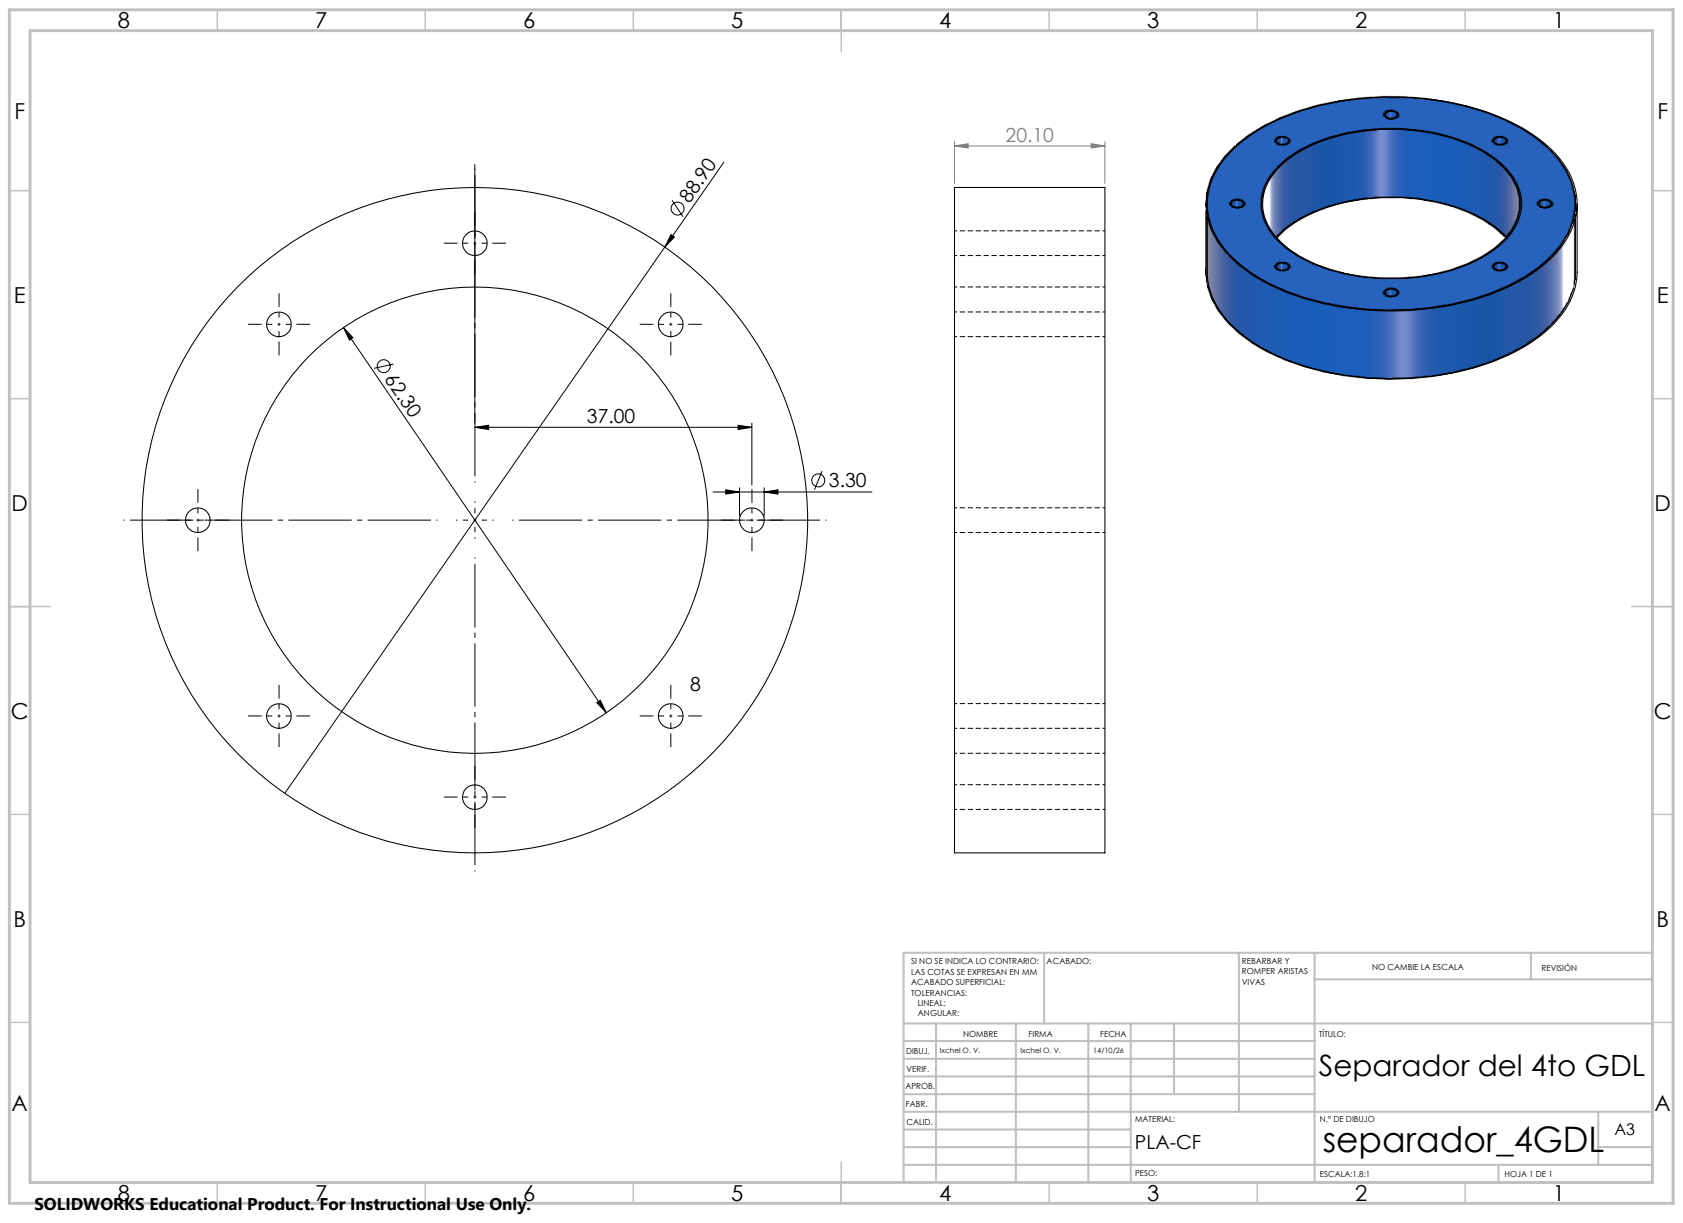
[picture p17: page 1]
ACABADO:; REBARBAR Y; ROMPER ARISTAS; NO CAMBIE LA ESCALA; REVISIÓN; ESCALA:1.8:1; HOJA 1 DE 1

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

NOMBRE | FIRMA | FECHA | | | | TÍTULO: Separador del 4to GDL

DIBUJ. | Ixchel O. V. | Ixchel O. V. | 14/10/26
VERIF.
APROB.
FABR.
CALID. | | | | MATERIAL: PLA-CF | N.º DE DIBUJO separador_4GDL | A3

SOLIDWORKS Educational Product. For Instructional Use Only.
