Omrover/MoMa-robot/docs/Diseños CAD/Dibujos 2D/sujecion_frontal_1GDL.pdf

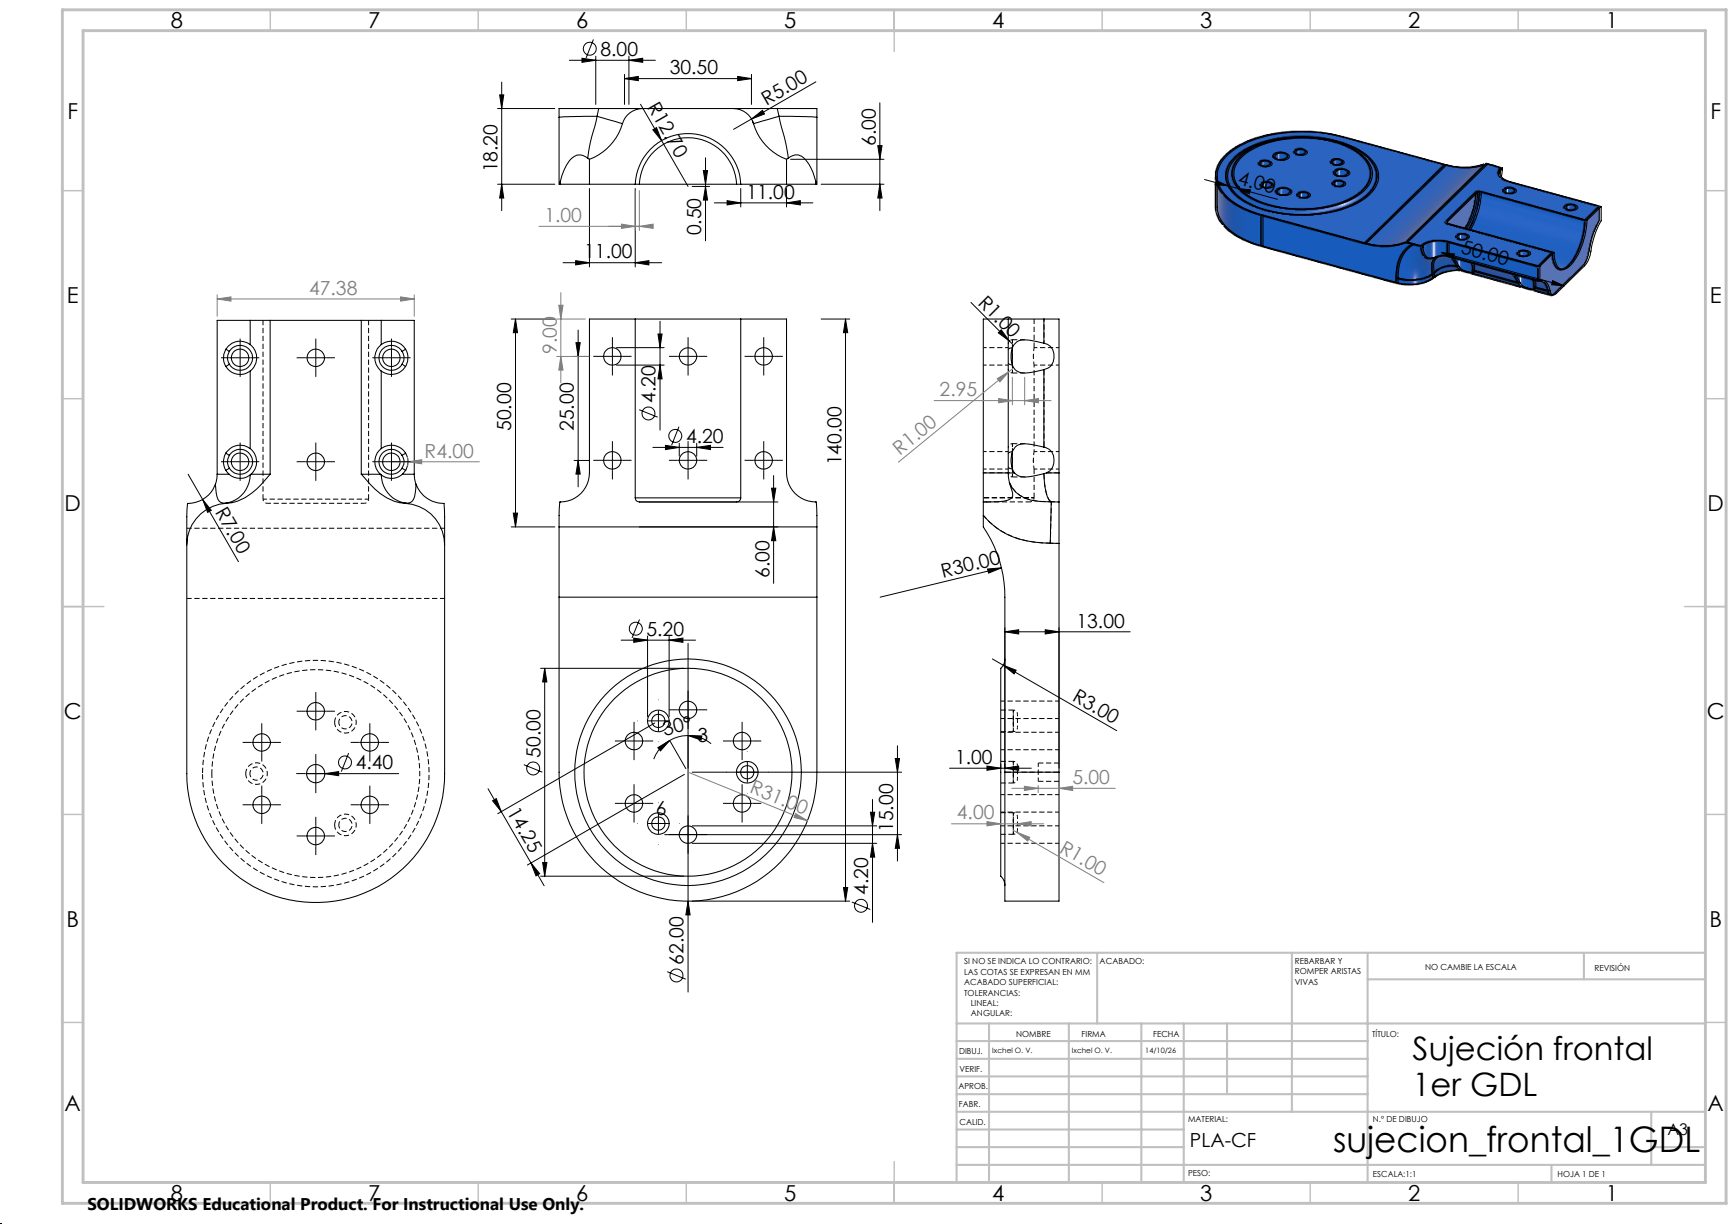
[picture p18: page 1]
1er GDL A; ACABADO:; REBARBAR Y; ROMPER ARISTAS; NO CAMBIE LA ESCALA; REVISIÓN; ESCALA:1:1; HOJA 1 DE 1

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

NOMBRE | FIRMA | FECHA | | | | Sujeción frontal TÍTULO:

DIBUJ. | Ixchel O. V. | Ixchel O. V. | 14/10/26
VERIF.
APROB.
FABR.
CALID. | | | | MATERIAL: sujecion_frontal_1GDL PLA-CF | N.º DE DIBUJO | A3

SOLIDWORKS Educational Product. For Instructional Use Only.
