Omrover/MoMa-robot/docs/Diseños CAD/Dibujos 2D/tubo_aluminio_2GDL.pdf

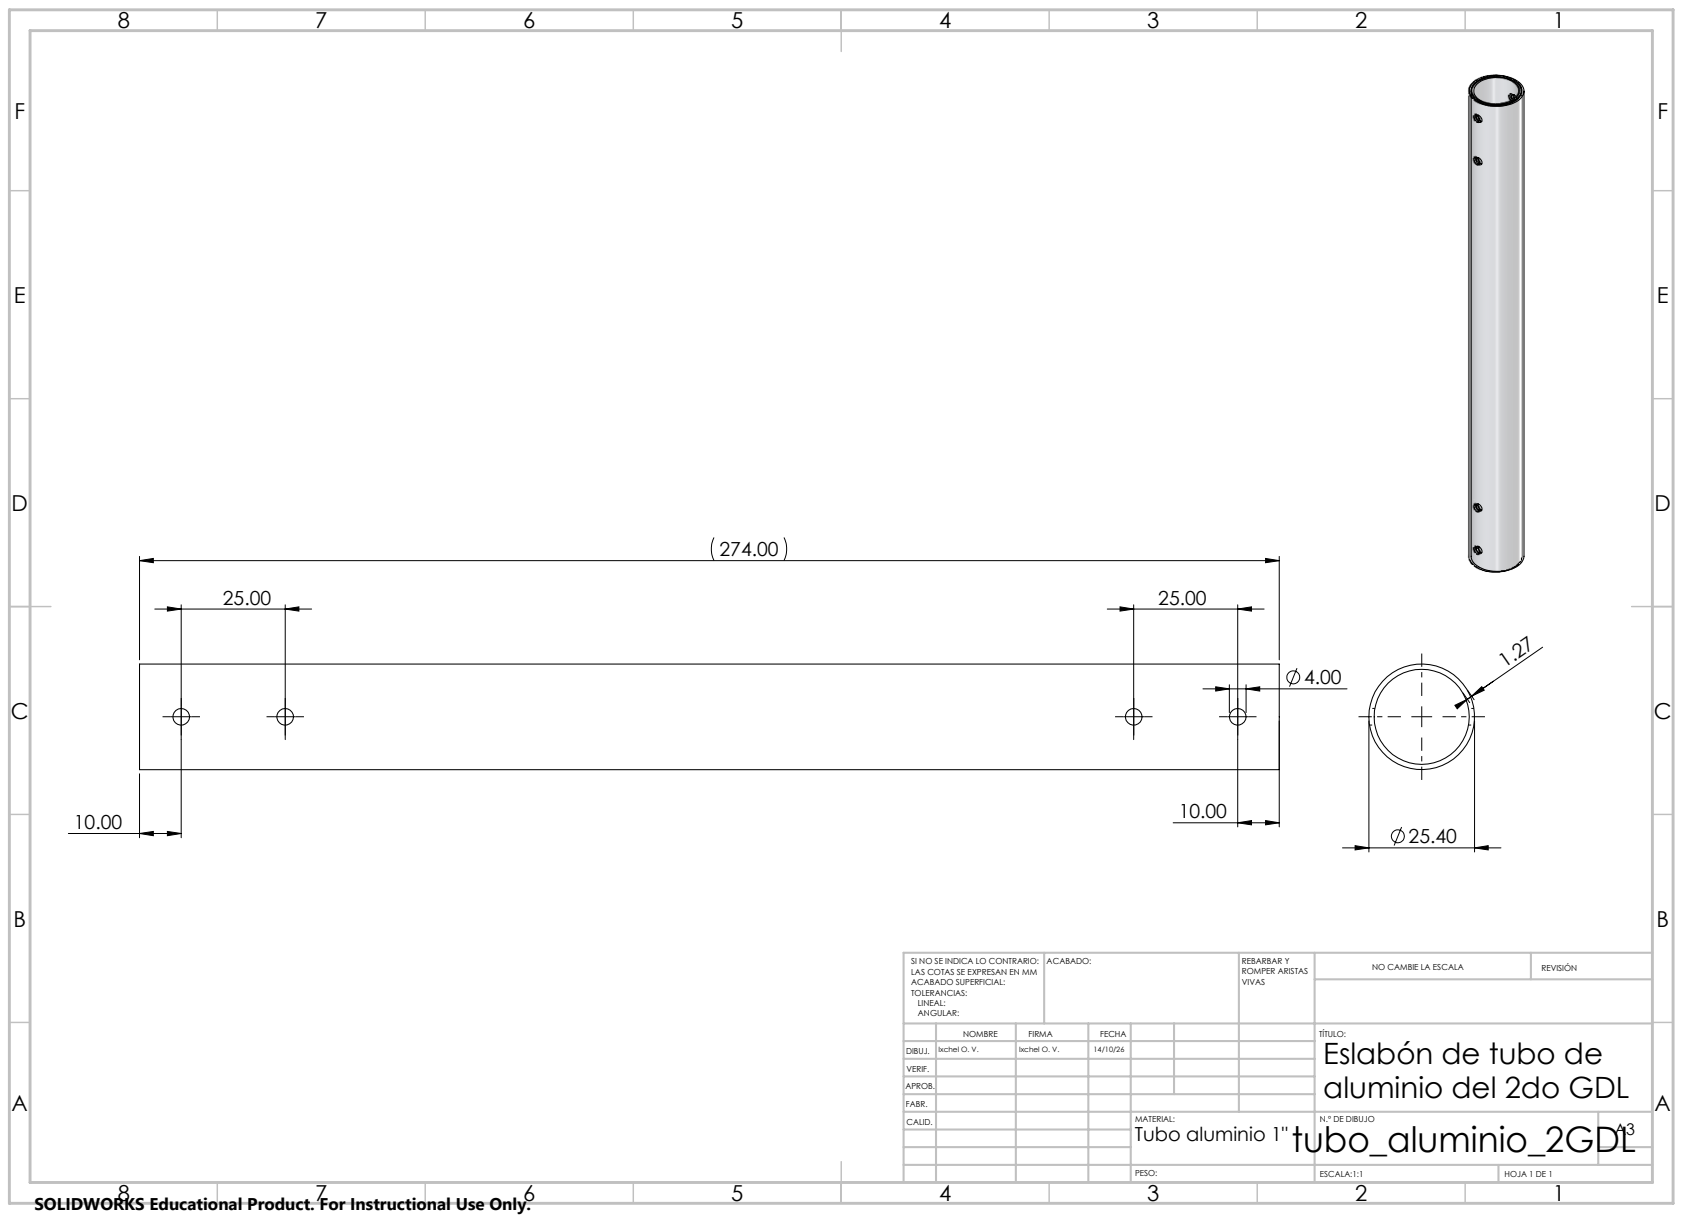
[picture p19: page 1]
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

NOMBRE | FIRMA | FECHA | | | | TÍTULO: Eslabón de tubo de aluminio del 2do GDL

DIBUJ. | Ixchel O. V. | Ixchel O. V. | 14/10/26
VERIF.
APROB.
FABR.
CALID. | | | | MATERIAL: tubo_aluminio_2GDL Tubo aluminio 1" | N.º DE DIBUJO | A3

SOLIDWORKS Educational Product. For Instructional Use Only.
